HLukas1/CodeBlockSwitchT4/T4 Codeblock Switcher.stl

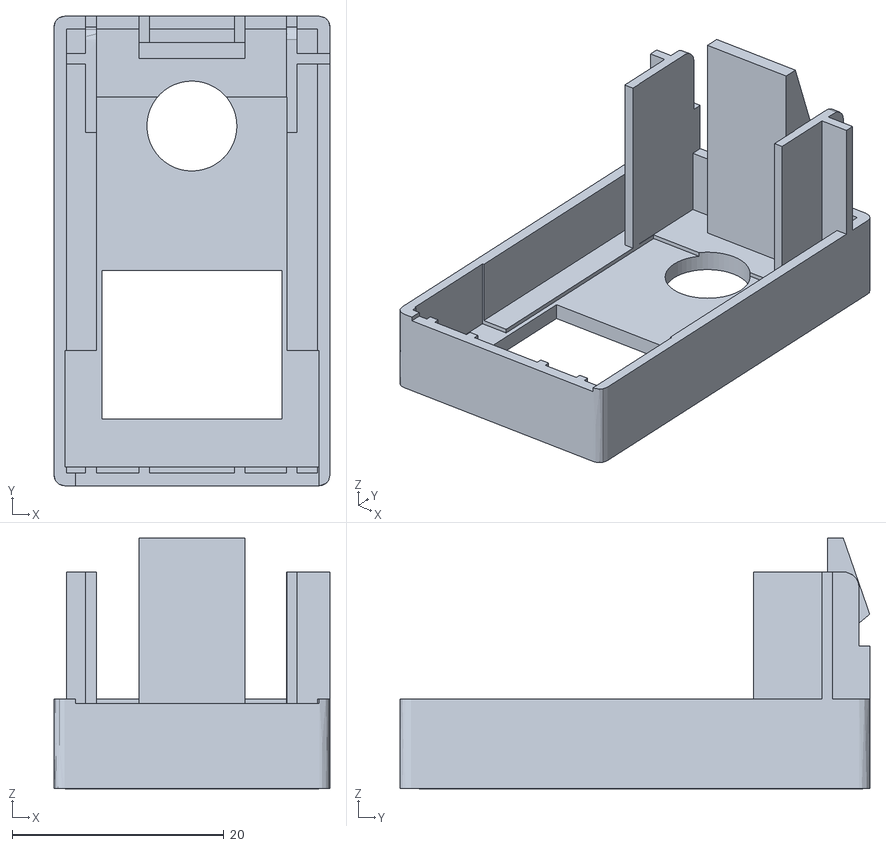
[picture p9: CAD file, 2026-11-06]
T4 Codeblock Switcher.stl
26.1 x 44.4 x 23.7
