HLukas1/CodeBlockSwitchT4/CodeBlockSwitchT4.ino

#include <Arduino.h>
#include <Wire.h>
#include <Adafruit_GFX.h>
#include <Adafruit_SSD1306.h>
#include <Fonts/FreeSans9pt7b.h>
#include <WiFi.h>
#include <WebServer.h>
#include <Preferences.h>
#include "WebPages.h"
#include "AppIcon.h"


// =====================================================
// ESP32-C3 / L9637D / KWP1281 /
//

#define KLINE_TX 10
#define KLINE_RX 1

#define MSG_ADDRESS 0x01

// =====================================================
// TESTBENCH-MODUS
// 0 = normaler Fahrzeugbetrieb
// 1 = Fahrzeugverbindung wird simuliert
// =====================================================
#define TESTBENCH_MODE 0

HardwareSerial obd(1);

//Displayeinstellungen
#define OLED_WIDTH 64
#define OLED_HEIGHT 48
#define OLED_RESET -1
#define OLED_ADDRESS 0x3C

#define OLED_SDA 6
#define OLED_SCL 7

Adafruit_SSD1306 display(
  OLED_WIDTH,
  OLED_HEIGHT,
  &Wire,
  OLED_RESET);

//Taster
#define BUTTON_INPUT 9
#define BUTTON_OUTPUT 5
// Eingebaute LED des ESP32-C3 SuperMini
#define LED_PIN 8

// Tastendauer - in der WebApp unter Einstellungen änderbar
// (Flash, Namespace "cfg"). Hier stehen die Standardwerte.
const uint32_t DEFAULT_LONG_PRESS_MS = 3000;

// Im Spannungsmodus -> Diagnose aus/an (K-Line frei für VCDS)
const uint32_t DEFAULT_DIAG_PRESS_MS = 5000;

volatile uint32_t buttonLongPressMs = DEFAULT_LONG_PRESS_MS;
volatile uint32_t buttonDiagPressMs = DEFAULT_DIAG_PRESS_MS;

// =====================================================
// EINSTELLUNGEN
// =====================================================

uint32_t KLINE_BAUD = 9600;

// 5 Baud = 200 ms pro Bit
const uint32_t FIVE_BAUD_BIT_US = 200000UL;

// Busruhe vor neuer Adressierung
const uint32_t BUS_IDLE_TIME_MS = 1200;

// Antwortabstand nach empfangenem Byte
const uint32_t TESTER_RESPONSE_DELAY_MS = 5;

// Abstand vor Komplement des zweiten Keybytes
const uint32_t KEYBYTE_COMPLEMENT_DELAY_MS = 30;

// Timeout innerhalb eines Blocks
const uint32_t INTERBYTE_TIMEOUT_MS = 55;

// Timeout zwischen zwei Blocks
const uint32_t INTERBLOCK_TIMEOUT_MS = 1100;

// Timeout waehrend Kommunikationsaufbau
const uint32_t INIT_TIMEOUT_MS = 250;

// Anzahl Verbindungsversuche
const uint8_t MAX_CONNECT_ATTEMPTS = 4;




// =====================================================
// GLOBALE VARIABLEN
// =====================================================

uint8_t blockCounter = 1;

uint16_t Coding = 0;
uint32_t WSC = 0;


uint16_t lastRpm = 0;
uint16_t lastBoostMbar = 0;
float injectionActual = 0.0;

float currentSpeed = 0.0;
float fuelConsumption = 0.0;

// =====================================================
// FAHRT-DURCHSCHNITT (nur RAM -> nach Neustart 0)
// =====================================================

float averageFuelConsumption = 0.0;

double tripFuelLiters = 0.0;
double tripDistanceKm = 0.0;

uint32_t lastAverageUpdateTime = 0;
uint32_t lastAverageMeasurementTime = 0;

// Durchschnitt alle 2 s aktualisieren
const uint32_t AVERAGE_MEASUREMENT_INTERVAL_MS = 2000;

// Unter dieser Geschwindigkeit nicht mitzählen (Standzeit)
const float FUEL_MIN_SPEED_KMH = 4.0f;

// Durchschnitt erst ab 100 m Fahrstrecke anzeigen
const double AVERAGE_MIN_DISTANCE_KM = 0.10;

// Glaettung Verbrauch (gleitender Mittelwert)
const uint8_t FUEL_AVG_SAMPLES = 35;

float fuelHourBuf[FUEL_AVG_SAMPLES] = {0};
float speedBuf[FUEL_AVG_SAMPLES] = {0};
uint8_t fuelBufIndex = 0;
uint8_t fuelBufCount = 0;

bool kwpConnected = false;

// Zeitpunkt des letzten vollständig empfangenen Blocks
uint32_t lastKwpRxTime = 0;

// Spätestens nach dieser Zeit ACK senden (SG-Timeout = 1100 ms)
const uint32_t KWP_KEEPALIVE_MS = 400;

// true = echter Leitungs-/Protokollfehler (Timeout, falsches Komplement)
// false = SG hat nur die Anfrage abgelehnt, Verbindung ist noch ok
bool kwpLinkError = false;

// Hilfsflag für kwpReceiveBlock-Wiederholung
bool kwpRxInterbyteTimeout = false;

// Aktuell im MSG vorhandene Codierung
uint16_t currentCodeblock = 0;

// =====================================================
// WLAN-HOTSPOT / WEBSERVER /SSID
// =====================================================

const char* AP_SSID = "CodeBlockSwitchT4";
const char* AP_PASS = "12345678";   // mind. 8 Zeichen

WebServer server(80);

// Zeitpunkt der letzten Webanfrage
uint32_t lastWebRequest = 0;

// So lange gilt die Webseite nach der letzten Anfrage als offen
const uint32_t WEB_ACTIVE_TIMEOUT_MS = 3000;

bool webClientActive() {
  return lastWebRequest != 0 &&
         (millis() - lastWebRequest) < WEB_ACTIVE_TIMEOUT_MS;
}


// =====================================================
// TASTER - EIGENER TASK + EREIGNIS-WARTESCHLANGE
// =====================================================

enum ButtonEvent : uint8_t {
  BTN_SHORT = 1,
  BTN_LONG  = 2,
  BTN_DIAG  = 3
};

QueueHandle_t buttonQueue = nullptr;

const uint32_t BUTTON_DEBOUNCE_MS = 30;
const uint32_t BUTTON_POLL_MS     = 5;
const uint8_t  BUTTON_QUEUE_LEN   = 10;

// Liegt ein noch nicht ausgeführter Tastendruck vor?
bool buttonPending() {
  return buttonQueue != nullptr &&
         uxQueueMessagesWaiting(buttonQueue) > 0;
}

// Messwertaktualisierung
uint32_t lastMeasurementTime = 0;
const uint32_t MEASUREMENT_INTERVAL_MS = 500;

uint32_t lastConnectAttempt = 0;
const uint32_t RECONNECT_PAUSE_MS = 15000;
// BETRIEBSMODI

enum DisplayMode {
  MODE_VOLTAGE,
  MODE_BOOST,
  MODE_CONSUMPTION,
  MODE_AVERAGE_CONSUMPTION,
  MODE_CUSTOM,
  MODE_CODEBLOCK
};

DisplayMode displayMode = MODE_VOLTAGE;

// =====================================================
// OLED-KONFIGURATION (wird im Flash gespeichert)
// =====================================================

Preferences prefs;

// Diagnose aus: keine K-Line-Kommunikation, Bildschirm fest auf
// Spannung. Bleibt nach Neustart erhalten (Namespace "diag").
bool diagDisabled = false;

const uint8_t SCR_VOLTAGE     = 0;
const uint8_t SCR_RPM         = 1;
const uint8_t SCR_BOOST       = 2;
const uint8_t SCR_CONSUMPTION = 3;
const uint8_t SCR_AVERAGE     = 4;
const uint8_t SCR_INJECTION   = 5;
const uint8_t SCR_CUSTOM1     = 10;   // 10..17 = eigene Messwerte

const uint8_t MAX_SCREENS = 12;
const uint8_t MAX_CUSTOM  = 8;

// Standard = bisherige Reihenfolge
uint8_t screenList[MAX_SCREENS] = {
  SCR_VOLTAGE, SCR_BOOST,
  SCR_CONSUMPTION, SCR_AVERAGE
};
uint8_t screenCount = 4;
uint8_t screenIndex = 0;
uint8_t currentScreenId = SCR_VOLTAGE;

// Eigene Messwerte (group = 0 -> Platz leer)
struct CustomScreen {
  uint8_t group;
  uint8_t field;

  // Automatisch aus der Messwerteblock-Tabelle übernommen
  char title[32];

  // Frei editierbare Einheit/Bezeichnung auf dem OLED
  char unit[10];
};

CustomScreen customScreens[MAX_CUSTOM];
uint8_t activeCustom = 0;

String customValueText = "-";
String customUnitText  = "";

// Letzte Livewerte aller eigenen Messwerte (für das Web-Dashboard)
String customLive[MAX_CUSTOM];
String customLiveUnit[MAX_CUSTOM];

// Einheiten der festen Bildschirme (Index = ID 0..5)
const char DEFAULT_UNITS[6][10] = {
  "V", "U/min", "mBar", "L/100km", "AVG L/100", "mg/Hub"
};

char baseUnits[6][10] = {
  "V", "U/min", "mBar", "L/100km", "AVG L/100", "mg/Hub"
};

// =====================================================
// VW STARTLOGO BITMAP 64x48
// =====================================================

const unsigned char vwLogo[] PROGMEM = {
  // 'Volkswagen-Logo-1967 (1)', 64x48px
  0x00, 0x00, 0x00, 0x00, 0x00, 0x00, 0x00, 0x00, 0x00, 0x00, 0x00, 0x00, 0x00, 0x00, 0x00, 0x00,
  0x00, 0x00, 0x00, 0x00, 0x00, 0x00, 0x00, 0x00, 0x00, 0x00, 0x00, 0x00, 0x00, 0x00, 0x00, 0x00,
  0x00, 0x00, 0x00, 0x0f, 0xf0, 0x00, 0x00, 0x00, 0x00, 0x00, 0x00, 0x7f, 0xfc, 0x00, 0x00, 0x00,
  0x00, 0x00, 0x00, 0xf0, 0x1e, 0x00, 0x00, 0x00, 0x00, 0x00, 0x01, 0xf0, 0x1f, 0x00, 0x00, 0x00,
  0x00, 0x00, 0x03, 0xb0, 0x19, 0x80, 0x00, 0x00, 0x00, 0x00, 0x03, 0x18, 0x19, 0xc0, 0x00, 0x00,
  0x00, 0x00, 0x06, 0x18, 0x30, 0xc0, 0x00, 0x00, 0x00, 0x00, 0x0c, 0x18, 0x30, 0x60, 0x00, 0x00,
  0x00, 0x00, 0x0c, 0x0c, 0x30, 0x60, 0x00, 0x00, 0x00, 0x00, 0x1c, 0x0c, 0x60, 0x70, 0x00, 0x00,
  0x00, 0x00, 0x1c, 0x06, 0x60, 0x70, 0x00, 0x00, 0x00, 0x00, 0x1e, 0x06, 0x40, 0xf0, 0x00, 0x00,
  0x00, 0x00, 0x12, 0x07, 0xc0, 0xd8, 0x00, 0x00, 0x00, 0x00, 0x13, 0x03, 0xc0, 0x98, 0x00, 0x00,
  0x00, 0x00, 0x33, 0x03, 0x81, 0x98, 0x00, 0x00, 0x00, 0x00, 0x31, 0x80, 0x01, 0x98, 0x00, 0x00,
  0x00, 0x00, 0x31, 0x80, 0x03, 0x08, 0x00, 0x00, 0x00, 0x00, 0x31, 0x83, 0x83, 0x18, 0x00, 0x00,
  0x00, 0x00, 0x10, 0xc3, 0x83, 0x18, 0x00, 0x00, 0x00, 0x00, 0x10, 0xc7, 0xc6, 0x18, 0x00, 0x00,
  0x00, 0x00, 0x18, 0xc6, 0xc6, 0x10, 0x00, 0x00, 0x00, 0x00, 0x18, 0x66, 0x64, 0x10, 0x00, 0x00,
  0x00, 0x00, 0x18, 0x6c, 0x6c, 0x30, 0x00, 0x00, 0x00, 0x00, 0x0c, 0x3c, 0x7c, 0x20, 0x00, 0x00,
  0x00, 0x00, 0x0c, 0x3c, 0x38, 0x60, 0x00, 0x00, 0x00, 0x00, 0x06, 0x38, 0x38, 0xc0, 0x00, 0x00,
  0x00, 0x00, 0x03, 0x18, 0x39, 0xc0, 0x00, 0x00, 0x00, 0x00, 0x03, 0x90, 0x13, 0x80, 0x00, 0x00,
  0x00, 0x00, 0x01, 0xf0, 0x1f, 0x00, 0x00, 0x00, 0x00, 0x00, 0x00, 0x78, 0x1e, 0x00, 0x00, 0x00,
  0x00, 0x00, 0x00, 0x3f, 0xf8, 0x00, 0x00, 0x00, 0x00, 0x00, 0x00, 0x0f, 0xe0, 0x00, 0x00, 0x00,
  0x00, 0x00, 0x00, 0x00, 0x00, 0x00, 0x00, 0x00, 0x00, 0x00, 0x00, 0x00, 0x00, 0x00, 0x00, 0x00,
  0x00, 0x00, 0x00, 0x00, 0x00, 0x00, 0x00, 0x00, 0x00, 0x00, 0x00, 0x00, 0x00, 0x00, 0x00, 0x00
};



// =====================================================
// KWP1281 MESSWERT
// =====================================================

struct KwpValue {
  bool    valid;    // Feld vorhanden und gelesen
  bool    isText;   // true = Ergebnis ist Text (z.B. COLD/WARM)
  uint8_t formula;  // Kennzahl (Byte 1)
  uint8_t a;        // Byte 2
  uint8_t b;        // Byte 3
  double  value;    // umgerechneter Messwert
  String  unit;     // Einheit
  String  text;     // Textergebnis
};

const uint8_t KWP_MAX_FIELDS = 4;

// =====================================================
// WEB: FREIE MESSWERTBLOCK-ANZEIGE
// =====================================================

uint8_t  webMwbGroup   = 0;      // gewünschter Block (0 = keiner)
uint32_t lastMwbRequest = 0;

KwpValue mwbData[KWP_MAX_FIELDS];
uint8_t  mwbCount     = 0;       // Anzahl gelesener Felder
uint8_t  mwbDataGroup = 0;       // Block, zu dem mwbData gehört
bool     mwbError     = false;

// =====================================================
// WEB: FEHLERSPEICHER
// =====================================================

struct KwpFault {
  uint16_t code;
  uint8_t type;
  bool sporadic;
};

const uint8_t KWP_MAX_FAULTS = 32;

KwpFault faultData[KWP_MAX_FAULTS];
uint8_t faultCount = 0;

bool faultMemoryValid = false;
bool faultMemoryError = false;
bool faultMemoryEmpty = false;
bool faultRequestRunning = false;

String faultStatusText = "Noch nicht gelesen";
// true = Fehlerspeicher wird gerade beim Start gelesen
bool startupFaultCheck = false;

// FSP-Hinweis nach dem Startcheck (10 s statt Spannung)
bool fspNoticeActive = false;
uint32_t fspNoticeStart = 0;
const uint32_t FSP_NOTICE_MS = 10000;

enum FaultRequestType {
  FAULT_REQUEST_NONE,
  FAULT_REQUEST_READ,
  FAULT_REQUEST_CLEAR
};

volatile FaultRequestType pendingFaultRequest =
  FAULT_REQUEST_NONE;
  
#include "FaultTable.h"

// Wird die MWB-Seite gerade abgefragt?
bool mwbActive() {
  return webMwbGroup > 0 &&
         lastMwbRequest != 0 &&
         (millis() - lastMwbRequest) < 3000;
}

String jsonEscape(const String &s) {
  String o;
  for (size_t i = 0; i < s.length(); i++) {
    char c = s[i];
    if (c == '"' || c == '\\') { o += '\\'; o += c; }
    else if ((uint8_t)c < 0x20) { o += '?'; }
    else o += c;   // UTF-8 (Umlaute, °) bleibt erhalten
  }
  return o;
}

#include "MwbTable.h"

// =====================================================
// FUNKTIONSPROTOTYPEN
// =====================================================

void printHex(uint8_t value);
void waitUntilMicros(uint32_t targetTime);

void stopKLine(bool waitForBusIdle);
void startKLine();
void clearKLineInput();

bool obdReadByte(uint8_t &value, uint32_t timeoutMs);
void obdWriteByte(uint8_t value);

void send5BaudAddress(uint8_t address);
bool readInitialResponse();

bool kwpReceiveBlock(
  uint8_t *buffer,
  uint16_t maxSize,
  uint16_t &size);

bool kwpSendBlockOnce(
  const uint8_t *buffer,
  uint16_t size);

bool kwpSendBlock(
  const uint8_t *buffer,
  uint16_t size);

bool kwpSendAck();
bool kwpSendEnd();

bool parseCodingBlock(
  const uint8_t *buffer,
  uint16_t size);

bool readIdentificationBlocks();

bool connectMSGOnce();
bool connectMSG(uint8_t maxAttempts = MAX_CONNECT_ATTEMPTS);
void disconnectMSG();

bool sendCoding(
  uint16_t requestedCoding,
  uint32_t requestedWSC);


void decodeKwpValue(KwpValue &v);

bool readMeasurementGroup(
  uint8_t group,
  KwpValue values[],
  uint8_t &fieldCount,
  bool printAllFields);

bool readMeasurement(
  uint8_t group,
  uint8_t field,
  KwpValue &out,
  bool printAllFields);

bool faultPageActive();

void calculateFuelConsumption();
float calculateLitersPerHour(uint16_t rpm, float injection);
void updateAverageFuelConsumption(float litersPerHour, float speedKmh);
bool readTripAverageValues();

void oledShowCustom();
void updateVoltageDisplay();
void applyScreen(uint8_t id);
void setCustomValue(bool isText, const String &text, double value, const String &unit);

bool readFaultMemory();
bool clearFaultMemory();
bool receiveFaultMemoryResponse();
bool parseFaultBlock(const uint8_t *buffer, uint16_t size);
void processFaultRequest();
String faultTypeText(uint8_t type);
String faultCodeText(uint16_t code);

int16_t getCenteredX(String text) {
  int16_t x1, y1;
  uint16_t w, h;

  display.getTextBounds(
    text,
    0,
    0,
    &x1,
    &y1,
    &w,
    &h);

  return (OLED_WIDTH - w) / 2;
}
// =====================================================
// HEX-AUSGABE
// =====================================================

void printHex(uint8_t value) {
  if (value < 0x10) {
    Serial.print("0");
  }

  Serial.print(value, HEX);
}


// =====================================================
// ZEITGENAUES WARTEN
// =====================================================

void waitUntilMicros(uint32_t targetTime) {
  while ((int32_t)(targetTime - micros()) > 0) {
    delayMicroseconds(50);
  }
}


// =====================================================
// K-LINE STOPPEN
// =====================================================

void stopKLine(bool waitForBusIdle) {
  obd.end();

  pinMode(KLINE_TX, OUTPUT);
  digitalWrite(KLINE_TX, HIGH);

  pinMode(KLINE_RX, INPUT);

  if (waitForBusIdle) {
    delay(BUS_IDLE_TIME_MS);
  }
}


// =====================================================
// K-LINE UART STARTEN
// =====================================================

void startKLine() {
  obd.end();

  obd.begin(
    KLINE_BAUD,
    SERIAL_8N1,
    KLINE_RX,
    KLINE_TX);
}


// =====================================================
// K-LINE-EINGANGSPUFFER LEEREN
// =====================================================

void clearKLineInput() {
  while (obd.available()) {
    obd.read();
  }
}




// =====================================================
// BYTE VON K-LINE LESEN
// =====================================================

bool obdReadByte(
  uint8_t &value,
  uint32_t timeoutMs) {
  uint32_t startTime = millis();

  while (!obd.available()) {
    if ((uint32_t)(millis() - startTime) >= timeoutMs) {
      return false;
    }

    delay(1);
  }

  value = (uint8_t)obd.read();

  return true;
}


// =====================================================
// BYTE AUF K-LINE SENDEN
// =====================================================

void obdWriteByte(uint8_t value) {
  obd.write(value);
  obd.flush();

  // Laut KW1281-Protokoll wird jedes vom µC gesendete
  // Byte vom Bus als Echo zurückgespiegelt, noch bevor
  // die eigentliche Antwort des Steuergeraets kommt.
  // Dieses Echo muss verworfen werden.
  uint8_t echo = 0;

  if (!obdReadByte(echo, INTERBYTE_TIMEOUT_MS)) {
    Serial.println("WARNUNG: Kein Echo auf gesendetes Byte.");
  } else if (echo != value) {
    Serial.print("WARNUNG: Echo 0x");
    printHex(echo);
    Serial.print(" weicht von gesendetem Byte 0x");
    printHex(value);
    Serial.println(" ab.");
  }
}


// =====================================================
// 5-BAUD-ADRESSE SENDEN
//
// 1 Startbit Low
// 7 Datenbits LSB zuerst
// 1 Bit ungerade Paritaet
// 1 Stopbit High
// =====================================================

void send5BaudAddress(uint8_t address) {
  Serial.println();
  Serial.println("========================================");
  Serial.println("       5-BAUD INITIALISIERUNG");
  Serial.println("========================================");

  stopKLine(true);

  uint8_t bits[10];

  // Startbit
  bits[0] = 0;

  uint8_t parity = 0;

  // Sieben Datenbits, LSB zuerst
  for (uint8_t i = 0; i < 7; i++) {
    uint8_t currentBit =
      (address >> i) & 0x01;

    bits[i + 1] = currentBit;

    parity ^= currentBit;
  }

  // Ungerade Paritaet
  bits[8] = parity ? 0 : 1;

  // Stopbit
  bits[9] = 1;

  Serial.print("Adresse: 0x");
  printHex(address);
  Serial.println();

  Serial.print("Bitfolge: ");

  for (uint8_t i = 0; i < 10; i++) {
    Serial.print(bits[i]);
  }

  Serial.println();

  uint32_t nextBitTime = micros();

  for (uint8_t i = 0; i < 10; i++) {
    digitalWrite(
      KLINE_TX,
      bits[i] ? HIGH : LOW);

    nextBitTime += FIVE_BAUD_BIT_US;

    waitUntilMicros(nextBitTime);
  }

  digitalWrite(KLINE_TX, HIGH);

  Serial.println("5-Baud-Adresse gesendet.");
}


// =====================================================
// INITIALANTWORT LESEN
//
// Erwartet:
//   55 01 8A
//
// Danach sendet der Tester:
//   75 = 8A XOR FF
// =====================================================

bool readInitialResponse() {
  Serial.println();
  Serial.println("----------------------------------------");
  Serial.println("        WARTE AUF 55 01 8A");
  Serial.println("----------------------------------------");

  uint8_t syncByte = 0;
  uint8_t keyByte1 = 0;
  uint8_t keyByte2 = 0;

  if (!obdReadByte(syncByte, INIT_TIMEOUT_MS)) {
    Serial.println(
      "FEHLER: Kein Synchronisationsbyte.");

    return false;
  }

  Serial.print("SYNC: 0x");
  printHex(syncByte);
  Serial.println();

  if (syncByte != 0x55) {
    Serial.println(
      "FEHLER: Synchronisationsbyte ist nicht 0x55.");

    return false;
  }

  if (!obdReadByte(keyByte1, INIT_TIMEOUT_MS)) {
    Serial.println("FEHLER: Keybyte 1 fehlt.");

    return false;
  }

  Serial.print("KB1: 0x");
  printHex(keyByte1);
  Serial.println();

  if (!obdReadByte(keyByte2, INIT_TIMEOUT_MS)) {
    Serial.println("FEHLER: Keybyte 2 fehlt.");

    return false;
  }

  Serial.print("KB2: 0x");
  printHex(keyByte2);
  Serial.println();

  if (
    keyByte1 != 0x01 || keyByte2 != 0x8A) {
    Serial.println(
      "FEHLER: Erwartetes Keyword 01 8A fehlt.");

    return false;
  }

  delay(KEYBYTE_COMPLEMENT_DELAY_MS);

  uint8_t complement =
    keyByte2 ^ 0xFF;

  Serial.print("TX KB2-Komplement: 0x");
  printHex(complement);
  Serial.println();

  obdWriteByte(complement);

  // Der erste Datenblock hat Blockzaehler 1.
  blockCounter = 1;

  return true;
}

// =====================================================
// KWP1281-BLOCK EINMAL EMPFANGEN
// =====================================================

bool kwpReceiveBlockOnce(
  uint8_t *buffer,
  uint16_t maxSize,
  uint16_t &size) {
  size = 0;

  uint8_t value = 0;

  // Merker: Abbruch mitten im Block?
  kwpRxInterbyteTimeout = false;

  Serial.println();
  Serial.print("Warte auf Block ");
  Serial.println(blockCounter);

  // Erstes Byte mit Interblock-Timeout
  if (!obdReadByte(
        value,
        INTERBLOCK_TIMEOUT_MS)) {
    Serial.println("FEHLER: Interblock-Timeout.");

    return false;
  }

  size = (uint16_t)value + 1U;

  if (size < 4) {
    Serial.println("FEHLER: Block zu klein.");

    return false;
  }

  if (size > maxSize) {
    Serial.println("FEHLER: Block zu gross.");

    return false;
  }

  buffer[0] = value;

  // Blocklaenge komplementieren
  delay(TESTER_RESPONSE_DELAY_MS);
  obdWriteByte(value ^ 0xFF);

  for (uint16_t index = 1; index < size; index++) {
    if (!obdReadByte(
          value,
          INTERBYTE_TIMEOUT_MS)) {
      Serial.print(
        "FEHLER: Interbyte-Timeout bei Index ");

      Serial.println(index);

      // SG wiederholt diesen Block laut KWP1281
      kwpRxInterbyteTimeout = true;

      return false;
    }

    buffer[index] = value;

    // Das letzte Byte ETX wird nicht komplementiert.
    if (index < size - 1) {
      delay(TESTER_RESPONSE_DELAY_MS);
      obdWriteByte(value ^ 0xFF);
    }
  }

  if (buffer[size - 1] != 0x03) {
    Serial.print("FEHLER: Ungueltiges ETX 0x");
    printHex(buffer[size - 1]);
    Serial.println();

    return false;
  }

  if (buffer[1] != blockCounter) {
    Serial.print(
      "FEHLER: Blockzaehler empfangen 0x");

    printHex(buffer[1]);

    Serial.print(", erwartet 0x");
    printHex(blockCounter);

    Serial.println();

    return false;
  }

  Serial.print("RX BLOCK: ");

  for (uint16_t i = 0; i < size; i++) {
    printHex(buffer[i]);
    Serial.print(" ");
  }

  Serial.println();

  blockCounter++;

  return true;
}


// =====================================================
// KWP1281-BLOCK EMPFANGEN MIT WIEDERHOLUNG
//
// Bricht der Empfang mitten im Block ab, sendet das SG
// den Block nach seinem Timeout erneut. Darauf wird
// einmal gewartet.
// =====================================================

bool kwpReceiveBlock(
  uint8_t *buffer,
  uint16_t maxSize,
  uint16_t &size) {

  for (uint8_t attempt = 0; attempt < 2; attempt++) {

    if (kwpReceiveBlockOnce(buffer, maxSize, size)) {
      // Erfolgreich -> Zeitstempel für Keep-Alive
      lastKwpRxTime = millis();
      return true;
    }

    // Nur bei Abbruch mitten im Block wiederholt das SG
    if (!kwpRxInterbyteTimeout) {
      break;
    }

    Serial.println("Warte auf Blockwiederholung durch SG...");

    // Reste des abgebrochenen Blocks verwerfen
    clearKLineInput();
  }

  // Endgültig fehlgeschlagen -> echter Leitungsfehler
  kwpLinkError = true;
  return false;
}


// =====================================================
// KWP1281-BLOCK EINMAL SENDEN
// =====================================================

bool kwpSendBlockOnce(
  const uint8_t *buffer,
  uint16_t size) {
  if (size < 4) {
    Serial.println("FEHLER: TX-Block zu klein.");

    return false;
  }

  if (buffer[1] != blockCounter) {
    Serial.print(
      "FEHLER: TX-Blockzaehler 0x");

    printHex(buffer[1]);

    Serial.print(", erwartet 0x");
    printHex(blockCounter);

    Serial.println();

    return false;
  }

  if (buffer[size - 1] != 0x03) {
    Serial.println("FEHLER: TX-Block ohne ETX.");

    return false;
  }

  Serial.print("TX BLOCK: ");

  for (uint16_t i = 0; i < size; i++) {
    printHex(buffer[i]);
    Serial.print(" ");
  }

  Serial.println();

  for (uint16_t index = 0; index < size; index++) {
    delay(TESTER_RESPONSE_DELAY_MS);

    uint8_t sentByte = buffer[index];

    obdWriteByte(sentByte);

    // Kein Komplement fuer ETX
    if (index == size - 1) {
      continue;
    }

    uint8_t receivedComplement = 0;

    if (!obdReadByte(
          receivedComplement,
          INTERBYTE_TIMEOUT_MS)) {
      Serial.print(
        "FEHLER: Kein Komplement fuer 0x");

      printHex(sentByte);
      Serial.println();

      return false;
    }

    uint8_t expectedComplement =
      sentByte ^ 0xFF;

    if (receivedComplement != expectedComplement) {
      Serial.print(
        "FEHLER: Komplement empfangen 0x");

      printHex(receivedComplement);

      Serial.print(", erwartet 0x");
      printHex(expectedComplement);

      Serial.println();

      return false;
    }
  }

  return true;
}


// =====================================================
// KWP1281-BLOCK MIT WIEDERHOLUNG SENDEN
// =====================================================

bool kwpSendBlock(
  const uint8_t *buffer,
  uint16_t size) {
  const uint8_t maxAttempts = 3;

  for (
    uint8_t attempt = 1;
    attempt <= maxAttempts;
    attempt++) {
    if (kwpSendBlockOnce(buffer, size)) {
      blockCounter++;

      return true;
    }

    if (attempt < maxAttempts) {
      Serial.print("Blockwiederholung ");
      Serial.print(attempt + 1);
      Serial.print(" von ");
      Serial.println(maxAttempts);

      delay(INTERBYTE_TIMEOUT_MS * 2UL);

      clearKLineInput();
    }
  }
  kwpLinkError = true;
  return false;
}


// =====================================================
// B01 ACKNOWLEDGE
//
// 03 ZZ 09 03
// =====================================================

bool kwpSendAck() {
  uint8_t block[4];

  block[0] = 0x03;
  block[1] = blockCounter;
  block[2] = 0x09;
  block[3] = 0x03;

  return kwpSendBlock(
    block,
    sizeof(block));
}


// =====================================================
// B03 AUSGABE-ENDE
//
// 03 ZZ 06 03
// =====================================================

bool kwpSendEnd() {
  uint8_t block[4];

  block[0] = 0x03;
  block[1] = blockCounter;
  block[2] = 0x06;
  block[3] = 0x03;

  Serial.println();
  Serial.println("Sende B03 Ausgabe-Ende.");

  bool result =
    kwpSendBlock(
      block,
      sizeof(block));

  kwpConnected = false;

  return result;
}

// =====================================================
// KEEP-ALIVE: B01 senden, B01 vom SG empfangen
// Hält die Verbindung ohne Neuadressierung offen
// =====================================================

void kwpKeepAlive() {
#if TESTBENCH_MODE
  return;
#endif

  if (!kwpConnected || faultRequestRunning) return;
  if (millis() - lastKwpRxTime < KWP_KEEPALIVE_MS) return;

  uint8_t buf[64];
  uint16_t size = 0;

  if (kwpSendAck() && kwpReceiveBlock(buf, sizeof(buf), size)) {
    return;   // normalerweise kommt 0x09 zurück
  }

  Serial.println("Keep-Alive fehlgeschlagen, Verbindung verloren.");
  stopKLine(false);
  kwpConnected = false;
  lastConnectAttempt = millis();
}

// =====================================================
// CODIERUNGSBLOCK AUSWERTEN
//
// Empfang:
//   08 ZZ F6 00 PP0 PP1 PP2 PP3 03
//
// Coding:
//   Coding = (PP0 PP1) / 2
//
// WSC:
//   PP1 Bit 0 = WSC16
//   PP2       = WSC15 bis WSC08
//   PP3       = WSC07 bis WSC00
// =====================================================

bool parseCodingBlock(
  const uint8_t *buffer,
  uint16_t size) {
  if (size != 9) {
    return false;
  }

  if (
    buffer[2] != 0xF6 || buffer[3] != 0x00 || buffer[8] != 0x03) {
    return false;
  }

  uint8_t pp0 = buffer[4];
  uint8_t pp1 = buffer[5];
  uint8_t pp2 = buffer[6];
  uint8_t pp3 = buffer[7];

  uint16_t codingRaw =
    ((uint16_t)pp0 << 8) | (uint16_t)pp1;

  Coding = codingRaw >> 1;

  WSC =
    ((uint32_t)(pp1 & 0x01) << 16) | ((uint32_t)pp2 << 8) | (uint32_t)pp3;

  Serial.println();
  Serial.println("************************************");
  Serial.println("        CODIERUNG EMPFANGEN");
  Serial.println("************************************");

  Serial.print("PP0 = 0x");
  printHex(pp0);

  Serial.print("  PP1 = 0x");
  printHex(pp1);

  Serial.print("  PP2 = 0x");
  printHex(pp2);

  Serial.print("  PP3 = 0x");
  printHex(pp3);

  Serial.println();

  Serial.print("Codierung = ");
  Serial.println(Coding);

  Serial.print("WSC       = ");
  Serial.println(WSC);

  Serial.println("************************************");

  return true;
}


// =====================================================
// IDENTIFIKATIONSBLOECKE LESEN
//
// Nach abschliessendem B01 bleibt die Verbindung offen.
// Der Tester besitzt dann die Master-Funktion.
// =====================================================

bool readIdentificationBlocks() {
  String identificationText = "";

  uint8_t buffer[256];
  uint16_t size = 0;

  uint8_t safetyCounter = 0;

  while (safetyCounter < 40) {
    safetyCounter++;

    if (!kwpReceiveBlock(
          buffer,
          sizeof(buffer),
          size)) {
      return false;
    }

    uint8_t blockTitle = buffer[2];

    if (blockTitle == 0xF6) {
      if (!parseCodingBlock(buffer, size)) {
        for (
          uint16_t i = 3;
          i < size - 1;
          i++) {
          uint8_t data = buffer[i];

          if (
            data >= 0x20 && data <= 0x7E) {
            identificationText +=
              (char)data;
          }
        }
      }

      if (!kwpSendAck()) {
        Serial.println(
          "FEHLER: B01 konnte nicht gesendet werden.");

        return false;
      }

      continue;
    }

    if (blockTitle == 0x09) {
      Serial.println();
      Serial.println(
        "B01 vom Steuergeraet empfangen.");

      Serial.println(
        "Tester besitzt jetzt die Master-Funktion.");

      if (identificationText.length() > 0) {
        Serial.print("MSG-Identifikation: ");
        Serial.println(identificationText);
      }

      return true;
    }

    if (blockTitle == 0x06) {
      Serial.println(
        "B03 vom Steuergeraet empfangen.");

      kwpConnected = false;

      return false;
    }

    if (blockTitle == 0x0A) {
      Serial.println(
        "FEHLER: No-Acknowledge empfangen.");

      return false;
    }

    Serial.print(
      "FEHLER: Unerwarteter Blocktitel 0x");

    printHex(blockTitle);
    Serial.println();

    return false;
  }

  Serial.println(
    "FEHLER: Zu viele Identifikationsbloecke.");

  return false;
}


// =====================================================
// EIN VERBINDUNGSVERSUCH
// =====================================================

bool connectMSGOnce() {
  kwpConnected = false;

  blockCounter = 1;
  Coding = 0;
  WSC = 0;

  send5BaudAddress(MSG_ADDRESS);

  // UART unmittelbar nach 5-Baud-Adresswort starten.
  startKLine();

  // Eingangspuffer hier nicht leeren.
  // Sonst kann 0x55 verloren gehen.

  if (!readInitialResponse()) {
    stopKLine(false);

    return false;
  }

  kwpConnected = true;

  if (!readIdentificationBlocks()) {
    kwpConnected = false;

    stopKLine(false);

    return false;
  }

  return true;
}


// =====================================================
// VERBINDEN MIT WIEDERHOLUNG
// =====================================================

bool connectMSG(uint8_t maxAttempts) { 

#if TESTBENCH_MODE
  kwpConnected = true;
  Coding = 2;
  WSC = 0;
 
  Serial.println("TESTBENCH: Fahrzeugverbindung simuliert.");
  return true;
#endif

  // Ab hier bleibt der bisherige Code von connectMSG()

  if (kwpConnected) {
    return true;
  }
  for (
    uint8_t attempt = 1;
    attempt <= maxAttempts;
    attempt++) {
    Serial.println();
    Serial.print("Verbindungsversuch ");
    Serial.print(attempt);
    Serial.print(" von ");
    Serial.println(maxAttempts);   

    if (connectMSGOnce()) {
      Serial.println();
      Serial.println("MSG verbunden.");

      Serial.print("Aktuelle Codierung: ");
      Serial.println(Coding);

      Serial.print("Aktueller WSC: ");
      Serial.println(WSC);

      return true;
    }

    Serial.println(
      "Verbindungsversuch fehlgeschlagen.");

    stopKLine(true);
  }

  Serial.println();
  Serial.println(
    "FEHLER: Keine Verbindung zum MSG.");

  return false;
}


// =====================================================
// VERBINDUNG BEENDEN
// =====================================================

void disconnectMSG() {

  if (kwpConnected) {

    if (!kwpSendEnd()) {

      Serial.println(
        "WARNUNG: B03 konnte nicht gesendet werden.");

      // Verbindung trotzdem hart beenden
      stopKLine(false);
      kwpConnected = false;

      return;
    }
  }

  stopKLine(false);

  kwpConnected = false;
}


// =====================================================
// B13 CODIERUNG SENDEN
//
// 07 ZZ 10 PP0 PP1 PP2 PP3 03
// =====================================================

bool sendCoding(
  uint16_t requestedCoding,
  uint32_t requestedWSC) {

#if TESTBENCH_MODE

  Serial.println("TESTBENCH: Codeblock-Schreiben simuliert.");

  Coding = requestedCoding;
  WSC = requestedWSC;

  return true;

#endif

  if (!kwpConnected) {
    Serial.println(
      "FEHLER: Keine aktive Verbindung.");

    return false;
  }

  if (requestedCoding > 32767) {
    Serial.println(
      "FEHLER: Codierung muss 0 bis 32767 sein.");

    return false;
  }

  if (requestedWSC > 131071UL) {
    Serial.println(
      "FEHLER: WSC muss 0 bis 131071 sein.");

    return false;
  }

  uint16_t codingRaw =
    (uint16_t)(requestedCoding << 1);

  uint8_t pp0 =
    (uint8_t)((codingRaw >> 8) & 0xFF);

  uint8_t pp1 =
    (uint8_t)(codingRaw & 0xFE);

  if (requestedWSC & 0x10000UL) {
    pp1 |= 0x01;
  }

  uint8_t pp2 =
    (uint8_t)((requestedWSC >> 8) & 0xFF);

  uint8_t pp3 =
    (uint8_t)(requestedWSC & 0xFF);

  uint8_t block[8];

  block[0] = 0x07;
  block[1] = blockCounter;
  block[2] = 0x10;
  block[3] = pp0;
  block[4] = pp1;
  block[5] = pp2;
  block[6] = pp3;
  block[7] = 0x03;

  Serial.println();
  Serial.println("========================================");
  Serial.println("       SENDE NEUE CODIERUNG");
  Serial.println("========================================");

  Serial.print("Neue Codierung: ");
  Serial.println(requestedCoding);

  Serial.print("Neuer WSC: ");
  Serial.println(requestedWSC);

  if (!kwpSendBlock(
        block,
        sizeof(block))) {
    Serial.println(
      "FEHLER: B13 konnte nicht gesendet werden.");

    return false;
  }

  // Nach B13 sendet das MSG erneut
  // die Identifikationsbloecke.
  if (!readIdentificationBlocks()) {
    Serial.println(
      "FEHLER: Keine Identifikation nach B13.");

    return false;
  }

  if (Coding != requestedCoding) {
    Serial.println();
    Serial.println(
      "FEHLER: Codierung wurde nicht uebernommen.");

    Serial.print("Angefordert: ");
    Serial.println(requestedCoding);

    Serial.print("Zurueckgelesen: ");
    Serial.println(Coding);

    return false;
  }

  Serial.println();
  Serial.println(
    "Codierung erfolgreich uebernommen.");

  Serial.print("Zurueckgelesene Codierung: ");
  Serial.println(Coding);

  Serial.print("Zurueckgelesener WSC: ");
  Serial.println(WSC);

  return true;
}

// =====================================================
// FEHLERSPEICHER: HILFSFUNKTIONEN
// =====================================================

String faultCodeText(uint16_t code) {
  String text = String(code);
  while (text.length() < 5) text = "0" + text;
  return text;
}

// Bit 7 = sporadisch, Bit 0..6 = Fehlerart
String faultTypeText(uint8_t type) {
  switch (type & 0x7F) {
    case 0x00: return "keine Angabe";
    case 0x01: return "Kurzschluss nach Plus";
    case 0x02: return "Kurzschluss nach Masse";
    case 0x03: return "kein Signal";
    case 0x04: return "mechanischer Fehler";
    case 0x05: return "Eingang offen";
    case 0x06: return "Signal zu groß";
    case 0x07: return "Signal zu klein";
    case 0x08: return "unplausibles Signal";
    case 0x09: return "Unterbrechung / Kurzschluss nach Masse";
    case 0x0A: return "Unterbrechung / Kurzschluss nach Plus";
    case 0x0B: return "Kurzschluss";
    case 0x0C: return "elektrischer Fehler";
    case 0x0D: return "bitte Fehlerspeicher auslesen";
    case 0x0E: return "defekt";
	case 0x23: return "";   // SAE/P-Code-Kennung, keine eigene Fehlerart
    default:   return "Fehlerart " + String(type & 0x7F);
  }
}

// =====================================================
// 0xFC-BLOCK AUSWERTEN
// LL ZZ FC [HH LL ART] x n 03
// =====================================================

bool parseFaultBlock(const uint8_t *buffer, uint16_t size) {
  if (size < 7 || buffer[2] != 0xFC) {
    Serial.println("FEHLER: Ungueltiger Fehlerspeicherblock.");
    return false;
  }

  if (((size - 4) % 3) != 0) {
    Serial.println("FEHLER: Ungueltige Anzahl Fehlerbytes.");
    return false;
  }

  for (uint16_t pos = 3; pos + 2 < size - 1; pos += 3) {
    uint16_t code = ((uint16_t)buffer[pos] << 8) | buffer[pos + 1];
    uint8_t type = buffer[pos + 2];

    // FFFF 88 = kein Fehler erkannt
    if (code == 0xFFFF && type == 0x88) {
      faultMemoryEmpty = true;
      continue;
    }

    if (faultCount >= KWP_MAX_FAULTS) continue;

    faultData[faultCount].code = code;
    faultData[faultCount].type = type;
    faultData[faultCount].sporadic = (type & 0x80) != 0;

    Serial.print("Fehler ");
    Serial.print(faultCodeText(code));
    Serial.print("  Art 0x");
    printHex(type);
    Serial.println(faultData[faultCount].sporadic ? "  sporadisch" : "  statisch");

    faultCount++;
  }

  return true;
}

// =====================================================
// ANTWORT EMPFANGEN (mehrere 0xFC-Bloecke moeglich)
// Jeder 0xFC wird mit B01 bestaetigt, Ende = B01 vom SG
// =====================================================

bool receiveFaultMemoryResponse() {
  uint8_t response[256];
  uint16_t responseSize = 0;

  for (uint8_t i = 0; i < 40; i++) {
    if (!kwpReceiveBlock(response, sizeof(response), responseSize)) {
      return false;
    }

    uint8_t title = response[2];

    if (title == 0xFC) {
      if (!parseFaultBlock(response, responseSize)) return false;
      if (!kwpSendAck()) return false;
      continue;
    }

    if (title == 0x09) return true;          // fertig

    if (title == 0x0A) {
      Serial.println("FEHLER: No-Acknowledge.");
      return false;
    }

    if (title == 0x06) {
      kwpConnected = false;
      return false;
    }

    Serial.print("FEHLER: Unerwarteter Blocktitel 0x");
    printHex(title);
    Serial.println();
    return false;
  }

  return false;
}

// =====================================================
// B06 LESEN: 03 ZZ 07 03
// =====================================================

bool readFaultMemory() {
  faultCount = 0;
  faultMemoryEmpty = false;

#if TESTBENCH_MODE
  faultData[0] = {257, 0x05, false};
  faultData[1] = {515, 0x88, true};
  faultCount = 2;
  return true;
#endif

  if (!kwpConnected) return false;

  uint8_t request[4] = {0x03, blockCounter, 0x07, 0x03};

  Serial.println("\n===== FEHLERSPEICHER LESEN =====");

  if (!kwpSendBlock(request, sizeof(request))) return false;

  return receiveFaultMemoryResponse();
}

// =====================================================
// B07 LOESCHEN: 03 ZZ 05 03
// SG gibt danach den Fehlerspeicher erneut aus
// =====================================================

bool clearFaultMemory() {
  faultCount = 0;
  faultMemoryEmpty = false;

#if TESTBENCH_MODE
  faultMemoryEmpty = true;
  return true;
#endif

  if (!kwpConnected) return false;

  uint8_t request[4] = {0x03, blockCounter, 0x05, 0x03};

  Serial.println("\n===== FEHLERSPEICHER LOESCHEN =====");

  if (!kwpSendBlock(request, sizeof(request))) return false;

  return receiveFaultMemoryResponse();
}

// =====================================================
// KWP1281 MESSWERT UMRECHNUNG ANHAND KENNZAHL
// Quelle: Klien Kennzahlen.xlsx
// =====================================================

void decodeKwpValue(KwpValue &v) {
  double a = v.a;
  double b = v.b;

  v.value  = 0.0;
  v.unit   = "";
  v.text   = "";
  v.isText = false;

  switch (v.formula) {
    case 1:  v.value = 0.2 * a * b;               v.unit = "U/min";   break;
    case 2:  v.value = a * 0.002 * b;             v.unit = "%";       break;
    case 3:  v.value = 0.002 * a * b;             v.unit = "Deg";     break;
    case 4:  v.value = fabs(b - 127) * 0.01 * a;
             v.unit  = (v.b > 127) ? "ATDC" : "BTDC";                break;
    case 5:  v.value = a * (b - 100) * 0.1;       v.unit = "C";       break;
    case 6:  v.value = 0.001 * a * b;             v.unit = "V";       break;
    case 7:  v.value = 0.01 * a * b;              v.unit = "km/h";    break;
    case 8:  v.value = 0.1 * a * b;               v.unit = "";        break;
    case 9:  v.value = (b - 127) * 0.02 * a;      v.unit = "Deg";     break;
    case 10: v.isText = true; v.text = (v.b == 0) ? "COLD" : "WARM";  break;
    case 11: v.value = 0.0001 * a * (b - 128) + 1; v.unit = "";       break;
    case 12: v.value = 0.001 * a * b;             v.unit = "Ohm";     break;
    case 13: v.value = (b - 127) * 0.001 * a;     v.unit = "mm";      break;
    case 14: v.value = 0.005 * a * b;             v.unit = "bar";     break;
    case 15: v.value = 0.01 * a * b;              v.unit = "ms";      break;
    case 16: v.isText = true; v.value = v.b;
             v.text = String(v.b, BIN);           v.unit = "bit";     break;
    case 17: v.isText = true;
             v.text = String((char)v.a) + String((char)v.b);          break;
    case 18: v.value = 0.04 * a * b;              v.unit = "mBar";    break;
    case 19: v.value = 0.01 * a * b;              v.unit = "l";       break;
    case 20: v.value = a * (b - 128) / 128.0;     v.unit = "%";       break;
    case 21: v.value = 0.001 * a * b;             v.unit = "V";       break;
    case 22: v.value = 0.001 * a * b;             v.unit = "ms";      break;
    case 23: v.value = b / 256.0 * a;             v.unit = "%";       break;
    case 24: v.value = 0.001 * a * b;             v.unit = "A";       break;
    case 25: v.value = (b * 1.421) + (a / 182.0); v.unit = "g/s";     break;
    case 26: v.value = b - a;                     v.unit = "C";       break;
    case 27: v.value = fabs(b - 128) * 0.01 * a;
             v.unit  = (v.b < 128) ? "ATDC" : "BTDC";                break;
    case 28: v.value = b - a;                     v.unit = "";        break;
    case 29: v.isText = true;
             v.text = (v.b < v.a) ? "1.Kennfeld" : "2.Kennfeld";      break;
    case 30: v.value = b / 12.0 * a;              v.unit = "Deg k/w"; break;
    case 31: v.value = b / 2560.0 * a;            v.unit = "C";       break;
    case 32: v.value = (v.b > 128) ? (b - 256) : b; v.unit = "";      break;
    case 33: v.value = (v.a == 0) ? (100 * b) : (100 * b / a);
             v.unit  = "%";                                           break;
    case 34: v.value = (b - 128) * 0.01 * a;      v.unit = "kW";      break;
    case 35: v.value = 0.01 * a * b;              v.unit = "l/h";     break;
    case 36: v.value = a * 2560 + b * 10;         v.unit = "km";      break;
    case 37: v.isText = true; v.value = v.b;
             v.text = "Oil Pr. 2 < min";                              break;
    case 38: v.value = (b - 128) * 0.001 * a;     v.unit = "Deg k/w"; break;
    case 39: v.value = b / 256.0 * a;             v.unit = "mg/Hub";  break;
    case 40: v.value = b * 0.1 + (25.5 * a) - 400; v.unit = "A";      break;
    case 41: v.value = b + a * 255;               v.unit = "Ah";      break;
    case 42: v.value = b * 0.1 + (25.5 * a) - 400; v.unit = "kW";     break;
    case 43: v.value = b * 0.1 + (25.5 * a);      v.unit = "V";       break;
    case 44: v.isText = true;
             v.text = String(v.a) + ":" + (v.b < 10 ? "0" : "") + String(v.b);
             v.unit = "h:m";                                          break;
    case 45: v.value = 0.1 * a * b / 100.0;       v.unit = "";        break;
    case 46: v.value = (a * b - 3200) * 0.0027;   v.unit = "Deg k/w"; break;
    case 47: v.value = (b - 128) * a;             v.unit = "ms";      break;
    case 48: v.value = b + a * 255;               v.unit = "";        break;
    case 49: v.value = (b / 4.0) * a * 0.1;       v.unit = "mg/Hub";  break;
    case 50: v.value = (v.a == 0) ? ((b - 128) / 0.01)
                                  : ((b - 128) / (0.01 * a));
             v.unit  = "mBar";                                        break;
    case 51: v.value = ((b - 128) / 255.0) * a;   v.unit = "mg/Hub";  break;
    case 52: v.value = b * 0.02 * a - a;          v.unit = "Nm";      break;
    case 53: v.value = (b - 128) * 1.4222 + 0.006 * a; v.unit = "g/s"; break;
    case 54: v.value = a * 256 + b;               v.unit = "Count";   break;
    case 55: v.value = a * b / 200.0;             v.unit = "s";       break;
    case 56: v.value = a * 256 + b;               v.unit = "WSC";     break;
    case 57: v.value = a * 256 + b + 65536;       v.unit = "WSC";     break;
    case 58: v.value = (v.b > 128) ? (1.0225 * (256 - b)) : (1.0225 * b);
             v.unit  = "/s";                                          break;
    case 59: v.value = (a * 256 + b) / 32768.0;   v.unit = "";        break;
    case 60: v.value = (a * 256 + b) * 0.01;      v.unit = "s";       break;
    case 61: v.value = (v.a == 0) ? (b - 128) : ((b - 128) / a);
             v.unit  = "";                                            break;
    case 62: v.value = 0.256 * a * b;             v.unit = "S";       break;
    case 63: v.isText = true;
             v.text = String((char)v.a) + String((char)v.b) + "?";   break;
    case 64: v.value = a + b;                     v.unit = "Ohm";     break;
    case 65: v.value = 0.01 * a * (b - 127);      v.unit = "mm";      break;
    case 66: v.value = (a * b) / 511.12;          v.unit = "V";       break;
    case 67: v.value = (640 * a) + b * 2.5;       v.unit = "Deg";     break;
    case 68: v.value = (256 * a + b) / 7.365;     v.unit = "deg/s";   break;
    case 69: v.value = (256 * a + b) * 0.3254;    v.unit = "bar";     break;
    case 70: v.value = (256 * a + b) * 0.192;     v.unit = "m/s2";    break;

    default:
      // Unbekannte Kennzahl: Rohwert b zurueckgeben
      v.value = b;
      v.unit  = "?";
      break;
  }
}


// =====================================================
// MESSWERTBLOCK KOMPLETT LESEN
//
// Anfrage:  04 ZZ 29 GG 03
// Antwort:  LL ZZ E7 [K a b] x max. 4  03
// =====================================================

bool readMeasurementGroup(
  uint8_t group,
  KwpValue values[],
  uint8_t &fieldCount,
  bool printAllFields) {

  fieldCount = 0;

  for (uint8_t i = 0; i < KWP_MAX_FIELDS; i++) {
    values[i].valid = false;
  }

  if (!kwpConnected) {
    Serial.println("FEHLER: Keine aktive Verbindung.");
    return false;
  }

  uint8_t request[5];
  request[0] = 0x04;
  request[1] = blockCounter;
  request[2] = 0x29;
  request[3] = group;
  request[4] = 0x03;

  if (!kwpSendBlock(request, sizeof(request))) {
    Serial.print("FEHLER: Group Reading MWB ");
    Serial.print(group);
    Serial.println(" konnte nicht gesendet werden.");
    return false;
  }

  uint8_t response[64];
  uint16_t responseSize = 0;

  if (!kwpReceiveBlock(response, sizeof(response), responseSize)) {
    Serial.print("FEHLER: Keine Antwort auf MWB ");
    Serial.println(group);
    return false;
  }

  if (response[2] == 0x0A) {
    Serial.println("FEHLER: MSG meldet No-Acknowledge.");
    return false;
  }

  if (response[2] != 0xE7) {
    Serial.print("FEHLER: Antworttitel ist 0x");
    printHex(response[2]);
    Serial.println(", erwartet wurde 0xE7.");
    return false;
  }

  uint16_t dataBytes = responseSize - 4;

  if (dataBytes == 0 || (dataBytes % 3) != 0) {
    Serial.println("FEHLER: Datenformat ist ungueltig.");
    return false;
  }

  uint16_t count = dataBytes / 3;
  if (count > KWP_MAX_FIELDS) {
    count = KWP_MAX_FIELDS;
  }

  for (uint8_t f = 0; f < count; f++) {
    uint16_t pos = 3 + (f * 3);

    values[f].formula = response[pos];
    values[f].a       = response[pos + 1];
    values[f].b       = response[pos + 2];

    decodeKwpValue(values[f]);
    values[f].valid = true;
  }

  fieldCount = (uint8_t)count;

  if (printAllFields) {
    Serial.println();
    Serial.print("MWB ");
    Serial.print(group);
    Serial.print(" RAW: ");
    for (uint16_t i = 0; i < responseSize; i++) {
      printHex(response[i]);
      Serial.print(" ");
    }
    Serial.println();

    for (uint8_t f = 0; f < fieldCount; f++) {
      Serial.print("Feld ");
      Serial.print(f + 1);
      Serial.print("  K=");
      Serial.print(values[f].formula);
      Serial.print("  a=");
      Serial.print(values[f].a);
      Serial.print("  b=");
      Serial.print(values[f].b);
      Serial.print("  -> ");

      if (values[f].isText) {
        Serial.print(values[f].text);
      } else {
        Serial.print(values[f].value, 2);
      }

      Serial.print(" ");
      Serial.println(values[f].unit);
    }
  }

  return true;
}

// =====================================================
// LADEDRUCK ALS UEBERDRUCK LESEN
//
// MWB 010 Feld 3 = Ladedruck (absolut)
// MWB 010 Feld 2 = Atmosphaerischer Druck
// Ueberdruck     = Feld 3 - Feld 2   [mBar]
// =====================================================

bool readBoostOverpressure() {
  KwpValue g10[KWP_MAX_FIELDS];
  uint8_t n = 0;

  if (!readMeasurementGroup(10, g10, n, false) || n < 3) {
    return false;
  }

  float overpressure =
    (float)g10[2].value - (float)g10[1].value;

  // Im Leerlauf kann es leicht negativ sein -> 0 anzeigen
  if (overpressure < 0.0f) {
    overpressure = 0.0f;
  }

  lastBoostMbar = (uint16_t)(overpressure + 0.5f);

  return true;
}

// =====================================================
// EINZELNEN MESSWERT LESEN
//
// group = Messwertblock (z.B. 1, 6, 11)
// field = Feld 1..4
// =====================================================

bool readMeasurement(
  uint8_t group,
  uint8_t field,
  KwpValue &out,
  bool printAllFields) {

  out.valid = false;

  if (field < 1 || field > KWP_MAX_FIELDS) {
    Serial.println("FEHLER: Feld muss 1 bis 4 sein.");
    return false;
  }

  KwpValue values[KWP_MAX_FIELDS];
  uint8_t fieldCount = 0;

  if (!readMeasurementGroup(group, values, fieldCount, printAllFields)) {
    return false;
  }

  if (field > fieldCount) {
    Serial.print("FEHLER: MWB ");
    Serial.print(group);
    Serial.print(" hat kein Feld ");
    Serial.println(field);
    return false;
  }

  out = values[field - 1];
  return true;
}



// =====================================================
// KRAFTSTOFF PRO STUNDE (L/h)
// 5-Zylinder, 4-Takt: 2,5 Einspritzungen pro Umdrehung
// Dieseldichte ca. 0,832 kg/L
// =====================================================

float calculateLitersPerHour(uint16_t rpm, float injection) {
  const float INJECTIONS_PER_REV = 2.5f;
  const float DIESEL_DENSITY_MG_PER_L = 832000.0f;

  float mgPerMinute =
    injection * (float)rpm * INJECTIONS_PER_REV;

  return (mgPerMinute / DIESEL_DENSITY_MG_PER_L) * 60.0f;
}

void calculateFuelConsumption() {

  float litersPerHour =
    calculateLitersPerHour(lastRpm, injectionActual);

  // -------------------------------------------------
  // BEI FAHRZEUGSTILLSTAND ZURUECKSETZEN
  // Wichtig: vor dem Eintragen in den Puffer prüfen.
  // -------------------------------------------------

  if (currentSpeed < 4.0f) {

    fuelConsumption = 0.0f;

    for (uint8_t i = 0; i < FUEL_AVG_SAMPLES; i++) {
      fuelHourBuf[i] = 0.0f;
      speedBuf[i] = 0.0f;
    }

    fuelBufCount = 0;
    fuelBufIndex = 0;

    Serial.print("Verbrauch: ");
    Serial.print(litersPerHour, 2);
    Serial.println(" L/h roh | 0.0 L/100km, Fahrzeug steht");

    return;
  }

  // -------------------------------------------------
  // AKTUELLEN WERT IN DEN RINGPUFFER SCHREIBEN
  // -------------------------------------------------

  fuelHourBuf[fuelBufIndex] = litersPerHour;
  speedBuf[fuelBufIndex] = currentSpeed;

  fuelBufIndex =
    (fuelBufIndex + 1) % FUEL_AVG_SAMPLES;

  if (fuelBufCount < FUEL_AVG_SAMPLES) {
    fuelBufCount++;
  }

  // -------------------------------------------------
  // MITTELWERTE BILDEN
  // -------------------------------------------------

  float sumFuel = 0.0f;
  float sumSpeed = 0.0f;

  for (uint8_t i = 0; i < fuelBufCount; i++) {
    sumFuel += fuelHourBuf[i];
    sumSpeed += speedBuf[i];
  }

  float avgFuelHour =
    sumFuel / (float)fuelBufCount;

  float avgSpeed =
    sumSpeed / (float)fuelBufCount;

  // -------------------------------------------------
  // VERBRAUCH BERECHNEN
  //
  // Unter 10 km/h Durchschnittsgeschwindigkeit wird
  // 0.0 angezeigt, damit beim Losfahren keine Werte
  // wie 50 bis 70 L/100km auftreten.
  // -------------------------------------------------

  if (avgSpeed < 10.0f) {

    fuelConsumption = 0.0f;

  } else {

    fuelConsumption =
      avgFuelHour * 100.0f / avgSpeed;
  }

  // -------------------------------------------------
  // SERIELLE AUSGABE
  // -------------------------------------------------

  Serial.print("Verbrauch: ");
  Serial.print(litersPerHour, 2);
  Serial.print(" L/h roh | ");

  Serial.print(fuelConsumption, 1);
  Serial.print(" L/100km geglaettet | ");

  Serial.print("Geschwindigkeit aktuell: ");
  Serial.print(currentSpeed, 1);
  Serial.print(" km/h | Mittel: ");
  Serial.print(avgSpeed, 1);
  Serial.println(" km/h");
}

// =====================================================
// FAHRT-DURCHSCHNITT AUFSUMMIEREN
//
// Durchschnitt = Gesamtliter / Gesamtkilometer * 100
// Standzeiten (< 4 km/h) werden nicht gezählt.
// =====================================================

void updateAverageFuelConsumption(float litersPerHour, float speedKmh) {

  uint32_t now = millis();

  // Erster Aufruf oder nach Pause: nur Zeitstempel setzen
  if (lastAverageUpdateTime == 0) {
    lastAverageUpdateTime = now;
    return;
  }

  uint32_t elapsedMs = now - lastAverageUpdateTime;
  lastAverageUpdateTime = now;

  // Lücken > 10 s ignorieren (Spannungsmodus, Fehlerspeicher,
  // Verbindungsabbruch) -> keine Sprünge
  if (elapsedMs == 0 || elapsedMs > 10000UL) {
    return;
  }

  // Standzeit nicht berücksichtigen
  if (speedKmh < FUEL_MIN_SPEED_KMH || litersPerHour < 0.0f) {
    return;
  }

  double hours = (double)elapsedMs / 3600000.0;

  tripFuelLiters += (double)litersPerHour * hours;
  tripDistanceKm += (double)speedKmh * hours;

  if (tripDistanceKm >= AVERAGE_MIN_DISTANCE_KM) {
    averageFuelConsumption =
      (float)(tripFuelLiters * 100.0 / tripDistanceKm);
  }

  Serial.print("Fahrt: ");
  Serial.print(tripDistanceKm, 3);
  Serial.print(" km | ");
  Serial.print(tripFuelLiters, 4);
  Serial.print(" L | AVG ");
  Serial.print(averageFuelConsumption, 1);
  Serial.println(" L/100km");
}

// =====================================================
// MWB 1 + MWB 6 FÜR DEN DURCHSCHNITT LESEN
// (wird in Modi ohne Verbrauchsanzeige alle 2 s genutzt)
// =====================================================

bool readTripAverageValues() {
  KwpValue g1[KWP_MAX_FIELDS];
  uint8_t n = 0;
  KwpValue speedValue;

  if (!readMeasurementGroup(1, g1, n, false) || n < 2) {
    return false;
  }

  uint16_t rpm = (uint16_t)g1[0].value;
  float injection = (float)g1[1].value;

  if (!readMeasurement(6, 1, speedValue, false)) {
    return false;
  }

  // Frische Werte gleich mit übernehmen
  lastRpm = rpm;
  injectionActual = injection;

  updateAverageFuelConsumption(
    calculateLitersPerHour(rpm, injection),
    (float)speedValue.value);

  return true;
}

// =====================================================
// OLED - NORMALE MESSWERTANZEIGE
// =====================================================

void oledShowValue(String value, String unit) {
  display.clearDisplay();
  display.setTextColor(SSD1306_WHITE);

  display.setTextSize(2);
  display.setCursor(getCenteredX(value), 23);
  display.print(value);

  display.setTextSize(1);
  display.setCursor(getCenteredX(unit), 40);
  display.print(unit);

  display.display();
}

void oledShowNormal() {
  if (displayMode == MODE_BOOST) {
    oledShowValue(String(lastBoostMbar), baseUnits[SCR_BOOST]);
  } else if (displayMode == MODE_CONSUMPTION) {
    oledShowValue(String(fuelConsumption, 1), baseUnits[SCR_CONSUMPTION]);
  } else if (displayMode == MODE_AVERAGE_CONSUMPTION) {
    oledShowValue(String(averageFuelConsumption, 1), baseUnits[SCR_AVERAGE]);
  } else if (displayMode == MODE_CUSTOM) {
    oledShowCustom();
  }
}

// Eigener Messwert: oben Wert, darunter Kurzname (oder Einheit)
void oledShowCustom() {
  CustomScreen &c = customScreens[activeCustom];

  String unitText = strlen(c.unit) > 0
                      ? String(c.unit)
                      : customUnitText;

  display.clearDisplay();
  display.setTextColor(SSD1306_WHITE);

  // Lange Texte, zum Beispiel Bitmuster, kleiner darstellen
  display.setTextSize(customValueText.length() <= 5 ? 2 : 1);
  display.setCursor(getCenteredX(customValueText), 23);
  display.print(customValueText);

  // Eigene beziehungsweise automatisch ermittelte Einheit
  display.setTextSize(1);
  display.setCursor(getCenteredX(unitText), 40);
  display.print(unitText);

  display.display();
}

// =====================================================
// OLED - CODEBLOCK MODUS
// =====================================================

void oledShowCodeblock() {
  display.clearDisplay();
  display.setTextColor(SSD1306_WHITE);

  // -------------------------------------------------
  // CB: 2 / CB: 3
  // -------------------------------------------------

  display.setTextSize(1);

  String title = "CB: " + String(currentCodeblock);

  int16_t tx = getCenteredX(title);

  display.setCursor(tx, 9);
  display.print(title);

  // -------------------------------------------------
  // LEISTUNG
  // -------------------------------------------------

  String power;

  if (currentCodeblock == 2) {
    power = "102PS";
  } else if (currentCodeblock == 3) {
    power = "138PS";
  } else {
    power = "???";
  }

  display.setTextSize(2);

  tx = getCenteredX(power);

  display.setCursor(tx, 24);
  display.print(power);

  display.display();
}

// =====================================================
// OLED - SCHREIBEN
// =====================================================

void oledShowWriting() {
  display.clearDisplay();
  display.setTextColor(SSD1306_WHITE);

  display.setTextSize(1);

  display.setCursor(0, 24);
  display.println("CODEBLOCK");


  display.setCursor(0, 36);
  display.println("Schreiben");

  display.display();
}


// =====================================================
// OLED - ERFOLG
// =====================================================

void oledShowSuccess() {
  display.clearDisplay();
  display.setTextColor(SSD1306_WHITE);

  display.setTextSize(1);

  display.setCursor(0, 12);
  display.println("CODEBLOCK");

  display.setCursor(0, 23);
  display.println("erfolgreich");

  display.setCursor(0, 34);
  display.println("geschrieben!");

  display.display();

  delay(1500);
}


// =====================================================
// OLED - FEHLER
// =====================================================

void oledShowError() {
  display.clearDisplay();
  display.setTextColor(SSD1306_WHITE);

  display.setTextSize(1);

  display.setCursor(0, 20);
  display.println("FEHLER!");

  display.setCursor(0, 28);
  display.println("Vorgang");

  display.setCursor(0, 35);
  display.println("fehlgeschlagen");

  display.display();

  delay(1500);
}

// =====================================================
// SPANNUNG MESSEN
// =====================================================

const int VOLTAGE_PIN = 0;

// Spannungsteiler
const float R_TOP = 47000000.0;
const float R_BOTTOM = 10000000.0;

// Korrekturwert in V - in der WebApp unter Einstellungen änderbar
const float DEFAULT_VOLTAGE_OFFSET = 0.0f;
float voltageOffset = DEFAULT_VOLTAGE_OFFSET;

// Messung
const int NUM_SAMPLES = 50;
const unsigned long VOLTAGE_DISPLAY_TIME = 500;

unsigned long lastVoltageDisplay = 0;

float measuredVoltage = 0.0;

// =====================================================
// SPANNUNG NUR MESSEN (ohne OLED)
// =====================================================

void measureVoltage() {
  long adcSum = 0;

  for (int i = 0; i < NUM_SAMPLES; i++) {
    adcSum += analogRead(VOLTAGE_PIN);
    delayMicroseconds(500);
  }

  float adcValue = adcSum / (float)NUM_SAMPLES;
  float adcVoltage = (adcValue / 4095.0) * 3.3;

  measuredVoltage =
    adcVoltage * ((R_TOP + R_BOTTOM) / R_BOTTOM);

  measuredVoltage += voltageOffset;
}

// =====================================================
// OLED - HINWEIS "X FSP gefunden"
// =====================================================

void oledShowFspNotice() {
  display.clearDisplay();
  display.setTextColor(SSD1306_WHITE);

  // Max. 9 Fehler -> "X FSP" passt immer in Größe 2
  String line1 = String(faultCount) + " FSP";

  display.setTextSize(1);
  display.setCursor(getCenteredX(line1), 24);
  display.print(line1);

  display.setTextSize(1);
  String line2 = "gefunden";
  display.setCursor(getCenteredX(line2), 36);
  display.print(line2);

  display.display();
}


// =====================================================
// SPANNUNG MESSEN UND ANZEIGEN
// =====================================================

void updateVoltageDisplay() {

  if (displayMode != MODE_VOLTAGE) {
    return;
  }

  if (millis() - lastVoltageDisplay < VOLTAGE_DISPLAY_TIME) {
    return;
  }

  lastVoltageDisplay = millis();

  // Diagnose aus -> Hinweis statt Spannung (Spannung fürs Web weiter messen)
  if (diagDisabled) {
    measureVoltage();
    oledShowValue("Diag", "aus");
    return;
  }

  // FSP-Hinweis hat für 10 s Vorrang vor der Spannung
  if (fspNoticeActive) {
    if (millis() - fspNoticeStart < FSP_NOTICE_MS) {
      oledShowFspNotice();
      return;
    }
    fspNoticeActive = false;
  }

  measureVoltage();

  // ------------------------------------------
  // Serieller Monitor
  // ------------------------------------------

  Serial.print("Spannung: ");
  Serial.print(measuredVoltage, 2);
  Serial.println(" V");

  // ------------------------------------------
  // OLED
  // ------------------------------------------

  display.clearDisplay();
  display.setTextColor(SSD1306_WHITE);




  // ----------------------------------------
  // Spannung
  // ----------------------------------------


  String voltageText = String(measuredVoltage, 1);

  if (strlen(baseUnits[SCR_VOLTAGE]) > 0) {
    voltageText += " ";
    voltageText += baseUnits[SCR_VOLTAGE];
  }

  // Eigene GFX-Schrift aktivieren
  display.setFont(&FreeSans9pt7b);
  display.setTextSize(1);

  // Schrift zentrieren
  int16_t x1, y1;
  uint16_t w, h;

  display.getTextBounds(
    voltageText,
    0,
    0,
    &x1,
    &y1,
    &w,
    &h);

  int x = (64 - w) / 2;

  // Bei GFX-Fonts ist die Y-Position die Baseline
  display.setCursor(x, 43);
  display.print(voltageText);

  // Danach wieder Standardschrift verwenden
  display.setFont(NULL);

  display.display();
}

// =====================================================
// OLED-KONFIGURATION: LADEN / SPEICHERN / ANZEIGEN
// =====================================================

bool screenValid(int id) {
  // Drehzahl und Einspritzmenge entfallen (über eigene Messwerte möglich)
  if (id == SCR_RPM || id == SCR_INJECTION) return false;

  if (id >= SCR_VOLTAGE && id <= SCR_INJECTION) return true;

  if (id >= SCR_CUSTOM1 && id < SCR_CUSTOM1 + MAX_CUSTOM) {
    return customScreens[id - SCR_CUSTOM1].group != 0;
  }

  return false;
}

void loadOledConfig() {
  memset(customScreens, 0, sizeof(customScreens));
  memcpy(baseUnits, DEFAULT_UNITS, sizeof(baseUnits));

  prefs.begin("oled", true);

  size_t n = prefs.getBytesLength("list");
  if (n > 0 && n <= MAX_SCREENS) {
    prefs.getBytes("list", screenList, n);
    screenCount = n;
  }

  if (prefs.getBytesLength("custom") == sizeof(customScreens)) {
    prefs.getBytes("custom", customScreens, sizeof(customScreens));
  }

  if (prefs.getBytesLength("units") == sizeof(baseUnits)) {
    prefs.getBytes("units", baseUnits, sizeof(baseUnits));
  }

  prefs.end();

  // Ungültige Einträge entfernen
  uint8_t w = 0;
  for (uint8_t i = 0; i < screenCount; i++) {
    if (screenValid(screenList[i])) {
      screenList[w++] = screenList[i];
    }
  }
  screenCount = w;

  if (screenCount == 0) {
    screenList[0] = SCR_VOLTAGE;
    screenCount = 1;
  }

  Serial.print("OLED-Konfiguration geladen, Bildschirme: ");
  Serial.println(screenCount);
}

void saveOledConfig() {
  prefs.begin("oled", false);
  prefs.putBytes("list", screenList, screenCount);
  prefs.putBytes("custom", customScreens, sizeof(customScreens));
  prefs.putBytes("units", baseUnits, sizeof(baseUnits));
  prefs.end();

  Serial.println("OLED-Konfiguration gespeichert.");
}

// Messwert als Text: ab 100 ohne, darunter mit 1 Nachkommastelle
String formatMeasurement(bool isText, const String &text, double value) {
  if (isText) {
    return text;
  }
  if (fabs(value) >= 100.0) {
    return String(value, 0);
  }
  return String(value, 1);
}

void setCustomValue(bool isText, const String &text, double value, const String &unit) {
  customValueText = formatMeasurement(isText, text, value);
  customUnitText = unit;

  customLive[activeCustom] = customValueText;
  customLiveUnit[activeCustom] = unit;
}

// Steht der Bildschirm in der OLED-Liste?
bool screenInList(uint8_t id) {
  for (uint8_t i = 0; i < screenCount; i++) {
    if (screenList[i] == id) return true;
  }
  return false;
}

// =====================================================
// WEB-DASHBOARD: EIGENE MESSWERTE REIHUM LESEN
// Pro Messzyklus ein Block, alle eigenen Messwerte aus
// diesem Block werden gleich mit übernommen.
// =====================================================

uint8_t webCustomCursor = 0;

bool readNextWebCustom() {
  for (uint8_t k = 0; k < screenCount; k++) {
    uint8_t i = (webCustomCursor + k) % screenCount;
    uint8_t id = screenList[i];

    if (id < SCR_CUSTOM1 || id >= SCR_CUSTOM1 + MAX_CUSTOM) continue;

    uint8_t slot = id - SCR_CUSTOM1;

    // Den Wert am OLED liest der Messzyklus ohnehin
    if (displayMode == MODE_CUSTOM && slot == activeCustom) continue;

    webCustomCursor = i + 1;

    uint8_t group = customScreens[slot].group;
    KwpValue vals[KWP_MAX_FIELDS];
    uint8_t n = 0;

    if (!readMeasurementGroup(group, vals, n, false)) {
      customLive[slot] = "-";
      return false;
    }

    for (uint8_t s = 0; s < MAX_CUSTOM; s++) {
      CustomScreen &o = customScreens[s];
      if (o.group == group && o.field >= 1 && o.field <= n) {
        KwpValue &f = vals[o.field - 1];
        customLive[s] = formatMeasurement(f.isText, f.text, f.value);
        customLiveUnit[s] = f.unit;
      }
    }
    return true;
  }

  // Keine weiteren eigenen Messwerte in der Liste
  return true;
}

// Bildschirm aktivieren
void applyScreen(uint8_t id) {
  // Diagnose aus -> immer Spannungsbildschirm (auch bei Web-Änderungen)
  if (diagDisabled) {
    id = SCR_VOLTAGE;
    screenIndex = 0;
    for (uint8_t i = 0; i < screenCount; i++) {
      if (screenList[i] == SCR_VOLTAGE) screenIndex = i;
    }
  }

  currentScreenId = id;
  lastVoltageDisplay = 0;

  switch (id) {
    case SCR_VOLTAGE:
      displayMode = MODE_VOLTAGE;
      Serial.println("MODE: SPANNUNG");
      updateVoltageDisplay();
      return;

    case SCR_BOOST:       displayMode = MODE_BOOST;               break;
    case SCR_CONSUMPTION: displayMode = MODE_CONSUMPTION;         break;
    case SCR_AVERAGE:     displayMode = MODE_AVERAGE_CONSUMPTION; break;


    default:
      displayMode = MODE_CUSTOM;
      activeCustom = id - SCR_CUSTOM1;
      customValueText = "-";
      customUnitText = "";
      break;
  }

  Serial.print("MODE-ID: ");
  Serial.println(id);

  oledShowNormal();
}

// Nach Änderung: aktuellen Bildschirm in neuer Liste wiederfinden
void syncScreenIndex() {
  if (displayMode == MODE_CODEBLOCK) return;

  for (uint8_t i = 0; i < screenCount; i++) {
    if (screenList[i] == currentScreenId &&
        screenValid(currentScreenId)) {
      screenIndex = i;
      return;
    }
  }

  // Aktueller Bildschirm wurde entfernt/gelöscht -> ersten anzeigen
  screenIndex = 0;
  applyScreen(screenList[0]);
}

// =====================================================
// CODEBLOCK-MODUS ÖFFNEN
// =====================================================

void enterCodeblockMode() {
  Serial.println();
  Serial.println("========================================");
  Serial.println("        CODEBLOCK MODUS");
  Serial.println("========================================");

  displayMode = MODE_CODEBLOCK;


  // -------------------------------------------------
  // Verbindung herstellen
  // -------------------------------------------------

  if (!kwpConnected) {
    if (lastConnectAttempt != 0 &&
        millis() - lastConnectAttempt < RECONNECT_PAUSE_MS) {
      oledShowValue("CB ?", "kein MSG");
      return;
    }

    bool ok = connectMSG(1);
    lastConnectAttempt = ok ? 0 : millis();

    if (!ok) {
      oledShowValue("CB ?", "kein MSG");
      return;
    }
  }
  // -------------------------------------------------
  // Aktuelle Codierung übernehmen
  // -------------------------------------------------

  currentCodeblock = Coding;

  // Nur 2 und 3 erlauben
  if (currentCodeblock != 2 && currentCodeblock != 3) {
    Serial.print("Unbekannter Codeblock: ");
    Serial.println(currentCodeblock);

    currentCodeblock = 2;
  }

  Serial.print("Aktueller Codeblock: ");
  Serial.println(currentCodeblock);

  // Verbindung nicht offen halten.
  // changeCodeblock() verbindet bei Bedarf neu.
  disconnectMSG();

  oledShowCodeblock();
}
// =====================================================
// CODEBLOCK 2 <-> 3
// =====================================================

void changeCodeblock() {

  if (displayMode != MODE_CODEBLOCK) {
    return;
  }

  oledShowWriting();

  // =====================================================
  // ZIEL BESTIMMEN
  // =====================================================

  uint16_t newCodeblock;

  if (currentCodeblock == 2) {
    newCodeblock = 3;
  } else {
    newCodeblock = 2;
  }

  Serial.println();
  Serial.println("========================================");
  Serial.println("       CODEBLOCK WECHSEL");
  Serial.println("========================================");

  Serial.print("Aktuell: ");
  Serial.println(currentCodeblock);

  Serial.print("Neu:     ");
  Serial.println(newCodeblock);

  // =====================================================
  // WICHTIG:
  // ALTE KWP-VERBINDUNG IMMER BEENDEN
  // =====================================================

  if (kwpConnected) {

    Serial.println();
    Serial.println("Beende alte KWP-Verbindung...");

    disconnectMSG();
  }

  // =====================================================
  // KURZ WARTEN
  // =====================================================

  delay(100);

  // =====================================================
  // NEU MIT MSG VERBINDEN
  // =====================================================

  Serial.println();
  Serial.println("Verbinde MSG fuer Codeblock-Schreiben...");

  if (!connectMSG()) {

    Serial.println();
    Serial.println("FEHLER: Verbindung zum MSG fehlgeschlagen.");

    oledShowError();
    return;
  }

  Serial.println();
  Serial.println("MSG erneut verbunden.");

  Serial.print("Aktuelle Codierung: ");
  Serial.println(Coding);

  Serial.print("Aktueller WSC: ");
  Serial.println(WSC);
  
    // Ziel immer aus der gerade gelesenen Codierung bestimmen
  if (Coding != 2 && Coding != 3) {
    Serial.println("FEHLER: Unbekannte Codierung, es wird nichts geschrieben.");
    disconnectMSG();
    oledShowError();
    oledShowValue("CB ?", "unbekannt");
    return;
  }

  currentCodeblock = Coding;
  newCodeblock = (Coding == 2) ? 3 : 2;

  Serial.print("Ziel (nach Neuverbindung): ");
  Serial.println(newCodeblock);

  // =====================================================
  // WSC ÜBERNEHMEN
  // =====================================================

  uint32_t unchangedWSC = WSC;

  // =====================================================
  // CODEBLOCK SCHREIBEN
  // =====================================================


  bool result = sendCoding(
    newCodeblock,
    unchangedWSC);

  // =====================================================
  // VERBINDUNG BEENDEN
  // =====================================================

  if (result) {

    disconnectMSG();

  } else {

    Serial.println();
    Serial.println("B13 fehlgeschlagen.");

    // Keine weitere B03-Kommunikation erzwingen,
    // wenn das MSG bereits nicht mehr antwortet.

    stopKLine(false);
    kwpConnected = false;
  }

  // =====================================================
  // ERGEBNIS
  // =====================================================

  if (result) {

    currentCodeblock = newCodeblock;

    Serial.println();
    Serial.println("========================================");
    Serial.print("Codeblock erfolgreich geändert auf: ");
    Serial.println(currentCodeblock);
    Serial.println("========================================");

    oledShowCodeblock();

  } else {

    Serial.println();
    Serial.println("Codeblock-Wechsel fehlgeschlagen.");

    oledShowError();

    // Alten Codeblock weiter anzeigen
    oledShowCodeblock();
  }
}


// =====================================================
// TASTER-TASK
// Fragt den Taster alle 5 ms ab, entprellt und legt
// jedes Ereignis in die Warteschlange.
// Langer Druck wird bereits während des Haltens ausgelöst.
// =====================================================

void buttonTask(void *param) {
  bool rawPressed    = (digitalRead(BUTTON_INPUT) == LOW);
  bool stablePressed = rawPressed;

  uint32_t lastRawChange = millis();
  uint32_t pressStart    = millis();

  // Beim Einschalten bereits gedrückt -> diesen Druck ignorieren
  bool longSent = stablePressed;
  bool diagSent = stablePressed;

  for (;;) {
    uint32_t now = millis();
    bool raw = (digitalRead(BUTTON_INPUT) == LOW);

    // Jede Pegeländerung startet die Entprellzeit neu
    if (raw != rawPressed) {
      rawPressed = raw;
      lastRawChange = now;
    }

    // Zustand erst übernehmen, wenn er stabil ist
    if (rawPressed != stablePressed &&
        (uint32_t)(now - lastRawChange) >= BUTTON_DEBOUNCE_MS) {

      stablePressed = rawPressed;

      if (stablePressed) {
        // Gedrückt
        pressStart = now;
        longSent = false;
        diagSent = false;
      } else if (!longSent) {
        // Losgelassen vor langem Druck -> kurzer Druck
        ButtonEvent ev = BTN_SHORT;
        xQueueSend(buttonQueue, &ev, 0);
      }
    }

    // Langer Druck (Std. 3 s): sofort auslösen, nicht erst beim Loslassen
    if (stablePressed && !longSent &&
        (uint32_t)(now - pressStart) >= buttonLongPressMs) {

      ButtonEvent ev = BTN_LONG;
      xQueueSend(buttonQueue, &ev, 0);
      longSent = true;
    }

    // Sehr langer Druck (Std. 5 s): zusätzlich (Diagnose aus/an)
    if (stablePressed && !diagSent &&
        (uint32_t)(now - pressStart) >= buttonDiagPressMs) {

      ButtonEvent ev = BTN_DIAG;
      xQueueSend(buttonQueue, &ev, 0);
      diagSent = true;
    }

    vTaskDelay(pdMS_TO_TICKS(BUTTON_POLL_MS));
  }
}

// =====================================================
// TASTER AUSWERTEN
//
// KURZ:
//   Spannung       -> Drehzahl
//   Drehzahl       -> Ladedruck
//   Ladedruck      -> Verbrauch
//   Verbrauch      -> Einspritzmenge
//   Einspritzmenge -> Codeblock
//   Codeblock      -> Spannung
//
// LANG:
//   Im Codeblock-Modus:
//   Codeblock 2 <-> 3
//
// 5 s:
//   Im Spannungsmodus: Diagnose aus <-> an
//   Bei Diagnose aus wird alles andere ignoriert.
// =====================================================

// Diagnose ein-/ausschalten und im Flash speichern
void setDiagnosisDisabled(bool off) {
  diagDisabled = off;

  prefs.begin("diag", false);
  prefs.putBool("off", off);
  prefs.end();

  if (off) {
    Serial.println("DIAGNOSE AUS - K-Line frei");

    // Offene Anfragen verwerfen, Verbindung sauber beenden (B03)
    pendingFaultRequest = FAULT_REQUEST_NONE;
    startupFaultCheck = false;
    fspNoticeActive = false;

    if (kwpConnected) {
      disconnectMSG();
    }
    faultStatusText = "Diagnose aus";
  } else {
    Serial.println("DIAGNOSE AN");

    // Nächster Messzyklus verbindet sofort neu
    lastConnectAttempt = 0;
    faultStatusText = "";
  }

  applyScreen(SCR_VOLTAGE);
}

void handleButton() {
  if (buttonQueue == nullptr) return;

  ButtonEvent ev;

  while (xQueueReceive(buttonQueue, &ev, 0) == pdTRUE) {

    // ===================================================
    // 5 S DRUCK -> DIAGNOSE AUS / AN
    // ===================================================
    if (ev == BTN_DIAG) {
      if (displayMode == MODE_VOLTAGE) {
        setDiagnosisDisabled(!diagDisabled);
      }
      continue;
    }

    // Diagnose aus -> kein Bildschirmwechsel, kein Codeblock
    if (diagDisabled) {
      continue;
    }

    // ===================================================
    // LANGER DRUCK
    // ===================================================
    if (ev == BTN_LONG) {
      Serial.println("LANGER DRUCK");

      if (displayMode == MODE_CODEBLOCK) {
        Serial.println("Wechsle Codeblock...");
        changeCodeblock();
      } else {
        Serial.println("Langer Druck ausserhalb Codeblock ignoriert.");
      }
      continue;
    }

    // ===================================================
    // KURZER DRUCK
    // ===================================================
    Serial.println("KURZER DRUCK");

    // Codeblock -> zurück zum ersten Bildschirm
    if (displayMode == MODE_CODEBLOCK) {
      if (kwpConnected) {
        disconnectMSG();
      }
      screenIndex = 0;
      applyScreen(screenList[0]);
      continue;
    }

    // Nächster Bildschirm aus der Liste
    screenIndex++;

    if (screenIndex >= screenCount) {
      Serial.println("MODE: CODEBLOCK");
      enterCodeblockMode();
    } else {
      applyScreen(screenList[screenIndex]);
    }
  }
}

// =====================================================
// MESSWERTE AUTOMATISCH AKTUALISIEREN
// =====================================================

void updateMeasurements() {

  bool webActive = webClientActive();
  
    // Tastendruck wartet -> erst im nächsten loop() ausführen
  if (buttonPending()) {
    return;
  }

  // Diagnose aus -> K-Line bleibt komplett frei
  if (diagDisabled) {
    updateVoltageDisplay();
    return;
  }

  // Fehlerspeicher-Seite offen -> keine Live-Messwerte auf der K-Line,
  // Spannungsanzeige am OLED läuft weiter
  if (faultPageActive()) {
    updateVoltageDisplay();
    return;
  }

  // =====================================================
  // SPANNUNG
  // =====================================================

  if (displayMode == MODE_VOLTAGE) {
    // Spannung kommt vom ADC. KWP läuft trotzdem weiter,
    // damit der Fahrt-Durchschnitt von Anfang an mitzählt.
    updateVoltageDisplay();
  }

  // =====================================================
  // CODEBLOCK -> nie für Web lesen
  // =====================================================

  if (displayMode == MODE_CODEBLOCK) {
    return;
  }

  // =====================================================
  // INTERVALL
  // =====================================================

  if (millis() - lastMeasurementTime < MEASUREMENT_INTERVAL_MS) {
    return;
  }

  lastMeasurementTime = millis();

  // Spannung für Web auch außerhalb des Spannungsmodus
  if (webActive && displayMode != MODE_VOLTAGE) {
    measureVoltage();
  }

  if (buttonPending()) {
    return;
  }

  // Verbindung herstellen (1 Versuch, danach 15 s Pause)
  if (!kwpConnected) {
    if (lastConnectAttempt != 0 &&
        millis() - lastConnectAttempt < RECONNECT_PAUSE_MS) {
      return;
    }

    lastConnectAttempt = millis();

    if (!connectMSG(1)) {
      return;
    }

    // Verbindung erfolgreich -> beim nächsten Abbruch sofort neu versuchen
    lastConnectAttempt = 0;
  }
  // =====================================================
  // MESSWERT LESEN
  // =====================================================

#if TESTBENCH_MODE

  lastRpm = 900;
  lastBoostMbar = 1000;
  injectionActual = 42.5;

  bool readOk = true;

#else
  bool readOk = false;
  kwpLinkError = false;


  KwpValue v;

  // ================================================
  // WEBSEITE OFFEN -> ALLE LIVEWERTE
  // MWB 001 Feld 1+2, MWB 010 Feld 2
  // ================================================

  if (webActive && mwbActive()) {
    // MWB-Seite offen: nur den gewählten Block lesen
    uint8_t n = 0;
    readOk = readMeasurementGroup(webMwbGroup, mwbData, n, false);
    if (readOk) {
      mwbCount = n;
      mwbDataGroup = webMwbGroup;
      mwbError = false;

      // OLED zeigt eigenen Messwert
      if (displayMode == MODE_CUSTOM) {
        CustomScreen &c = customScreens[activeCustom];

        if (c.group == webMwbGroup) {
          if (c.field <= n) {
            KwpValue &cv = mwbData[c.field - 1];
            setCustomValue(cv.isText, cv.text, cv.value, cv.unit);
          }
        } else if (readMeasurement(c.group, c.field, v, false)) {
          setCustomValue(v.isText, v.text, v.value, v.unit);
        }
      }
    } else {
      mwbCount = 0;
      mwbError = true;
    }
  }

  else if (webActive) {
    // Dashboard offen -> alle Werte der OLED-Liste lesen
    KwpValue g1[KWP_MAX_FIELDS];
    uint8_t n = 0;

    if (readMeasurementGroup(1, g1, n, false) && n >= 2) {
      lastRpm = (uint16_t)g1[0].value;
      injectionActual = (float)g1[1].value;
      readOk = true;

      // Ueberdruck = MWB 010 Feld 3 - Feld 2
      if (screenInList(SCR_BOOST) || displayMode == MODE_BOOST) {
        readOk = readBoostOverpressure();
      }
	  
      // OLED zeigt eigenen Messwert -> zusätzlich lesen
      if (readOk && displayMode == MODE_CUSTOM) {
        CustomScreen &c = customScreens[activeCustom];
        readOk = readMeasurement(c.group, c.field, v, false);
        if (readOk) {
          setCustomValue(v.isText, v.text, v.value, v.unit);
        }
      }

      // Weitere eigene Messwerte fürs Dashboard (einer pro Zyklus)
      if (readOk && !readNextWebCustom() && kwpLinkError) {
        readOk = false;
      }

      // Verbrauch im Dashboard oder am OLED -> zusätzlich Geschwindigkeit
      if (readOk &&
          (screenInList(SCR_CONSUMPTION) || displayMode == MODE_CONSUMPTION)) {
        readOk = readMeasurement(6, 1, v, false);
        if (readOk) {
          currentSpeed = (float)v.value;
          calculateFuelConsumption();

          updateAverageFuelConsumption(
            calculateLitersPerHour(lastRpm, injectionActual),
            currentSpeed);
          lastAverageMeasurementTime = millis();
        }
      }
    }
  }


  // ================================================
  //   -> MWB 010 Feld 2
  // ================================================

  else if (displayMode == MODE_BOOST) {
    // Ueberdruck = MWB 010 Feld 3 - Feld 2
    readOk = readBoostOverpressure();
  }

  // ================================================
  // VERBRAUCH -> MWB 001 Feld 1+2, MWB 006 Feld 1
  // ================================================

  else if (displayMode == MODE_CONSUMPTION) {
    KwpValue g1[KWP_MAX_FIELDS];
    uint8_t n = 0;

    if (readMeasurementGroup(1, g1, n, false) && n >= 2) {
      lastRpm = (uint16_t)g1[0].value;
      injectionActual = (float)g1[1].value;

      if (readMeasurement(6, 1, v, false)) {
        currentSpeed = (float)v.value;
        calculateFuelConsumption();

        updateAverageFuelConsumption(
          calculateLitersPerHour(lastRpm, injectionActual),
          currentSpeed);
        lastAverageMeasurementTime = millis();

        readOk = true;
      }
    }
  }

  // ================================================
  // DURCHSCHNITT -> Werte kommen aus Block 8d
  // ================================================

  else if (displayMode == MODE_AVERAGE_CONSUMPTION) {
    // Jeden Zyklus lesen -> Verbindung bleibt aktiv
    // und der Durchschnitt wird genauer
    readOk = readTripAverageValues();
    lastAverageMeasurementTime = millis();
  }

  // ================================================
  // EIGENER MESSWERT -> gespeicherter Block / Feld
  // ================================================

  else if (displayMode == MODE_CUSTOM) {
    CustomScreen &c = customScreens[activeCustom];
    readOk = readMeasurement(c.group, c.field, v, false);
    if (readOk) {
      setCustomValue(v.isText, v.text, v.value, v.unit);
    }
  }

  // ================================================
  // SPANNUNG -> nichts zu lesen, nur Fahrt-Durchschnitt (unten)
  // ================================================

  else if (displayMode == MODE_VOLTAGE) {
    readOk = true;
  }


  // ================================================
  // FAHRT-DURCHSCHNITT IN ALLEN ANDEREN MODI
  // Alle 2 s MWB 1 + MWB 6 zusätzlich lesen.
  // Nicht, wenn die freie MWB-Webseite offen ist.
  // Im Durchschnittsmodus selbst läuft es ebenfalls hierüber.
  // ================================================

  if (readOk &&
      !mwbActive() &&
	  !buttonPending() &&
      millis() - lastAverageMeasurementTime >=
        AVERAGE_MEASUREMENT_INTERVAL_MS) {

    lastAverageMeasurementTime = millis();

    if (!readTripAverageValues()) {
      // Verbindung vermutlich gestört -> wie gewohnt zurücksetzen
      readOk = false;
    }
  }

  if (!readOk) {

    // SG hat nur abgelehnt -> Verbindung behalten
    if (kwpConnected && !kwpLinkError) {
      Serial.println("SG hat Anfrage abgelehnt, Verbindung bleibt bestehen.");
      return;
    }

    Serial.println();
    Serial.println("Messwert fehlgeschlagen.");
    Serial.println("Verbindung wird zurueckgesetzt.");

    // Kein blockierendes Warten noetig, Reconnect-Pause ist 15 s
    stopKLine(false);
    kwpConnected = false;
    lastConnectAttempt = millis();

    // Spannungsanzeige nicht überschreiben
    if (displayMode != MODE_VOLTAGE) {
      oledShowValue("---", "kein MSG");
    }
    return;
  }

#endif

  // =====================================================
  // OLED (im Spannungsmodus macht oledShowNormal nichts)
  // =====================================================

  oledShowNormal();
}

// =====================================================
// CODEBLOCK-WECHSEL AUS DEM WEB ABARBEITEN
// =====================================================

volatile uint16_t pendingCodeblockTarget = 0;
bool codeblockCyclePending = false;   // Erfolg -> WebApp meldet Zündungswechsel
String codeblockError = "";

void processCodeblockRequest() {
  if (pendingCodeblockTarget == 0) return;

  uint16_t target = pendingCodeblockTarget;
  pendingCodeblockTarget = 0;

  Serial.print("WEB: Codeblock-Wechsel auf ");
  Serial.println(target);

  oledShowWriting();
  kwpLinkError = false;

  bool result = false;
  String error = "";

  // Schreiben wie am Taster: immer über eine frische Verbindung
  if (kwpConnected) {
    disconnectMSG();
  }
  delay(100);

  if (!connectMSG()) {
    error = "Keine Verbindung zum MSG";
  } else if (Coding != 2 && Coding != 3) {
    error = "Unbekannte Codierung, nichts geschrieben";
  } else if (Coding == target) {
    error = String(target == 2 ? "102" : "138") + " PS ist bereits aktiv";
  } else if (sendCoding(target, WSC)) {
    result = true;
  } else {
    error = "Schreiben fehlgeschlagen";
  }

  // Bei Fehlern keine weitere Kommunikation erzwingen
  if (result) {
    disconnectMSG();
  } else if (kwpConnected) {
    stopKLine(false);
    kwpConnected = false;
  }

  lastConnectAttempt = millis();
  lastMeasurementTime = millis();

  if (Coding == 2 || Coding == 3) {
    currentCodeblock = Coding;
  }

  codeblockCyclePending = result;
  codeblockError = error;

  if (!result) {
    Serial.print("WEB: Codeblock-Wechsel fehlgeschlagen: ");
    Serial.println(error);
    oledShowError();
  }

  // OLED wieder wie vorher
  if (displayMode == MODE_CODEBLOCK) {
    oledShowCodeblock();
  } else {
    applyScreen(currentScreenId);
  }
}

// =====================================================
// FEHLERSPEICHER-ANFORDERUNG AUS DEM WEB ABARBEITEN
// =====================================================

void processFaultRequest() {
  if (pendingFaultRequest == FAULT_REQUEST_NONE) return;

  FaultRequestType request = pendingFaultRequest;
  pendingFaultRequest = FAULT_REQUEST_NONE;

  // Diagnose aus -> Anfrage aus dem Web ablehnen
  if (diagDisabled) {
    faultMemoryValid = false;
    faultMemoryError = true;
    faultStatusText = "Diagnose aus (am Gerät 5 s drücken)";
    return;
  }

  faultRequestRunning = true;
  faultMemoryError = false;
  faultMemoryValid = false;
  


  bool result = false;
  kwpLinkError = false;

  // connectMSG() gibt sofort true zurück, wenn bereits verbunden
  if (connectMSG(startupFaultCheck ? 1 : MAX_CONNECT_ATTEMPTS)) {
    result = (request == FAULT_REQUEST_READ)
               ? readFaultMemory()
               : clearFaultMemory();
  }

  // Nur bei echtem Leitungsfehler trennen
  if (kwpConnected && kwpLinkError) {
    stopKLine(false);
    kwpConnected = false;
    lastConnectAttempt = millis();
  }

  if (result) {
    faultMemoryValid = true;

    if (faultCount == 0) {
      faultStatusText = (request == FAULT_REQUEST_CLEAR)
                          ? "Fehlerspeicher gelöscht"
                          : "Kein Fehler erkannt";
    } else {
      if (request == FAULT_REQUEST_CLEAR) {
        faultStatusText = "Gelöscht, aber Fehler weiterhin vorhanden";
      } else {
        faultStatusText = String(faultCount) + " Fehler gelesen";
      }
    }
  } else {
    faultMemoryError = true;
    faultStatusText = "Vorgang fehlgeschlagen";
  }

  faultRequestRunning = false;
  lastMeasurementTime = millis();

  // Nur beim Startcheck: gefundene FSP 10 s lang anzeigen
  if (startupFaultCheck && result && faultCount > 0) {
    fspNoticeActive = true;
    fspNoticeStart = millis();
  }

  startupFaultCheck = false;

  // Spannungsanzeige sofort neu zeichnen (mit/ohne "!")
  lastVoltageDisplay = 0;
  updateVoltageDisplay();
}




// =====================================================
// WEB-HANDLER
// =====================================================

void handleRoot() {
  lastWebRequest = millis();
  server.send(200, "text/html; charset=utf-8", INDEX_HTML);
}

// Gemeinsames Stylesheet aller Seiten
void handleAppCss() {
  server.sendHeader("Cache-Control", "max-age=86400");
  server.send(200, "text/css", APP_CSS);
}

// Codeblock aus der WebApp umschalten (?to=2 oder 3)
void handleApiCodeblock() {
  lastWebRequest = millis();

  const char *JSON_TYPE = "application/json; charset=utf-8";
  int to = server.arg("to").toInt();

  if (to != 2 && to != 3) {
    server.send(400, JSON_TYPE, "{\"ok\":false,\"msg\":\"Ungültiger Codeblock\"}");
    return;
  }
  if (diagDisabled) {
    server.send(409, JSON_TYPE, "{\"ok\":false,\"msg\":\"Diagnose ist aus\"}");
    return;
  }
  if (pendingCodeblockTarget != 0 || pendingFaultRequest != FAULT_REQUEST_NONE) {
    server.send(409, JSON_TYPE, "{\"ok\":false,\"msg\":\"Gerät ist beschäftigt\"}");
    return;
  }

  codeblockError = "";
  codeblockCyclePending = false;
  pendingCodeblockTarget = to;

  server.send(202, JSON_TYPE, "{\"ok\":true}");
}

// Meldung "Zündungswechsel" wurde bestätigt
void handleApiCodeblockAck() {
  lastWebRequest = millis();
  codeblockCyclePending = false;
  server.send(200, "application/json", "{\"ok\":true}");
}

// App-Icon (Browser-Tab und Startbildschirm)
void handleAppIcon() {
  server.sendHeader("Cache-Control", "max-age=86400");
  server.send_P(200, "image/png", (PGM_P)APP_ICON_PNG, APP_ICON_PNG_LEN);
}

void handleManifest() {
  server.sendHeader("Cache-Control", "max-age=86400");
  server.send(200, "application/manifest+json", APP_MANIFEST);
}

// Livewerte aller Bildschirme aus der OLED-Liste
//   k = 1 -> Wert kommt vom MSG (ohne Verbindung "-")
void handleApiLive() {
  lastWebRequest = millis();

  static const char *BASE_NAMES[6] = {
    "Spannung", "Drehzahl", "Ladedruck",
    "Verbrauch", "Durchschnitt", "Einspritzmenge"
  };

  String json = "{";
  json += "\"connected\":";
  json += kwpConnected ? "true" : "false";
  json += ",\"diag\":";
  json += diagDisabled ? "false" : "true";
  json += ",\"cb\":";
  json += displayMode == MODE_CODEBLOCK ? "true" : "false";
  json += ",\"cur\":";
  json += String(currentScreenId);
  json += ",\"coding\":";
  json += String(Coding);
  json += ",\"cbCycle\":";
  json += codeblockCyclePending ? "true" : "false";
  json += ",\"cbErr\":\"";
  json += jsonEscape(codeblockError);
  json += "\"";
  json += ",\"items\":[";

  for (uint8_t i = 0; i < screenCount; i++) {
    uint8_t id = screenList[i];
    String name, unit, value;
    bool fromMsg = true;

    if (id >= SCR_CUSTOM1 && id < SCR_CUSTOM1 + MAX_CUSTOM) {
      uint8_t slot = id - SCR_CUSTOM1;
      CustomScreen &c = customScreens[slot];

      name = strlen(c.title) > 0
               ? String(c.title)
               : "MWB " + String(c.group) + " Feld " + String(c.field);
      unit = strlen(c.unit) > 0 ? String(c.unit) : customLiveUnit[slot];
      value = customLive[slot].length() > 0 ? customLive[slot] : "-";
    } else if (id <= SCR_INJECTION) {
      name = BASE_NAMES[id];
      unit = baseUnits[id];

      switch (id) {
        case SCR_VOLTAGE:
          value = String(measuredVoltage, 1);
          fromMsg = false;
          break;
        case SCR_BOOST:       value = String(lastBoostMbar);              break;
        case SCR_CONSUMPTION: value = String(fuelConsumption, 1);         break;
        case SCR_AVERAGE:
          value = String(averageFuelConsumption, 1);
          fromMsg = false;   // bleibt nach Verbindungsabbruch gültig
          break;
        case SCR_RPM:         value = String(lastRpm);                    break;
        default:              value = String(injectionActual, 1);         break;
      }
    } else {
      continue;
    }

    if (i > 0) json += ",";
    json += "{\"id\":";
    json += String(id);
    json += ",\"n\":\"";
    json += jsonEscape(name);
    json += "\",\"u\":\"";
    json += jsonEscape(unit);
    json += "\",\"v\":\"";
    json += jsonEscape(value);
    json += "\",\"k\":";
    json += fromMsg ? "1" : "0";
    json += "}";
  }
  json += "]}";

  server.sendHeader("Cache-Control", "no-store");
  server.send(200, "application/json; charset=utf-8", json);
}

// =====================================================
// EINSTELLUNGEN (Flash, Namespace "cfg")
// =====================================================

// Gültigkeit prüfen, bei Fehler Meldung für die WebApp
String checkSettings(uint32_t lp, uint32_t dp, float vo) {
  if (lp < 1000 || lp > 10000) {
    return "Langer Druck: 1,0 bis 10,0 s";
  }
  if (dp < 2000 || dp > 20000) {
    return "Diagnose-Druck: 2,0 bis 20,0 s";
  }
  if (dp < lp + 1000) {
    return "Diagnose-Druck muss mind. 1 s länger sein als der lange Druck";
  }
  if (isnan(vo) || vo < -3.0f || vo > 3.0f) {
    return "Spannungskorrektur: -3,00 bis +3,00 V";
  }
  return "";
}

void loadSettings() {
  prefs.begin("cfg", true);
  uint32_t lp = prefs.getUInt("lp", DEFAULT_LONG_PRESS_MS);
  uint32_t dp = prefs.getUInt("dp", DEFAULT_DIAG_PRESS_MS);
  float vo = prefs.getFloat("vo", DEFAULT_VOLTAGE_OFFSET);
  prefs.end();

  // Kaputte Werte im Flash -> Standard verwenden
  if (checkSettings(lp, dp, vo).length() > 0) {
    lp = DEFAULT_LONG_PRESS_MS;
    dp = DEFAULT_DIAG_PRESS_MS;
    vo = DEFAULT_VOLTAGE_OFFSET;
  }

  buttonLongPressMs = lp;
  buttonDiagPressMs = dp;
  voltageOffset = vo;

  Serial.print("Einstellungen: lang ");
  Serial.print(lp);
  Serial.print(" ms, Diagnose ");
  Serial.print(dp);
  Serial.print(" ms, Offset ");
  Serial.print(vo, 2);
  Serial.println(" V");
}

void handleSettingsPage() {
  lastWebRequest = millis();
  server.send(200, "text/html; charset=utf-8", SETTINGS_HTML);
}

void handleApiSettings() {
  lastWebRequest = millis();

  String json = "{\"lp\":";
  json += String(buttonLongPressMs);
  json += ",\"dp\":";
  json += String(buttonDiagPressMs);
  json += ",\"vo\":";
  json += String(voltageOffset, 2);
  json += ",\"volt\":";
  json += String(measuredVoltage, 2);
  json += ",\"def\":{\"lp\":";
  json += String(DEFAULT_LONG_PRESS_MS);
  json += ",\"dp\":";
  json += String(DEFAULT_DIAG_PRESS_MS);
  json += ",\"vo\":";
  json += String(DEFAULT_VOLTAGE_OFFSET, 2);
  json += "}}";

  server.sendHeader("Cache-Control", "no-store");
  server.send(200, "application/json; charset=utf-8", json);
}

void handleApiSettingsSave() {
  lastWebRequest = millis();

  uint32_t lp = (uint32_t)server.arg("lp").toInt();
  uint32_t dp = (uint32_t)server.arg("dp").toInt();
  float vo = server.arg("vo").toFloat();

  String err = checkSettings(lp, dp, vo);
  if (err.length() > 0) {
    server.send(400, "application/json; charset=utf-8",
                "{\"ok\":false,\"msg\":\"" + jsonEscape(err) + "\"}");
    return;
  }

  buttonLongPressMs = lp;
  buttonDiagPressMs = dp;
  voltageOffset = vo;

  prefs.begin("cfg", false);
  prefs.putUInt("lp", lp);
  prefs.putUInt("dp", dp);
  prefs.putFloat("vo", vo);
  prefs.end();

  // Spannung sofort mit neuem Offset messen und anzeigen
  measureVoltage();
  lastVoltageDisplay = 0;

  Serial.println("Einstellungen gespeichert.");
  server.send(200, "application/json", "{\"ok\":true}");
}



void handleMwbPage() {
  lastWebRequest = millis();
  server.send(200, "text/html; charset=utf-8", MWB_HTML);
}

void handleApiMwb() {
  lastWebRequest = millis();
  lastMwbRequest = millis();

  if (server.hasArg("group")) {
    int g = server.arg("group").toInt();
    if (g >= 1 && g <= 255 && g != webMwbGroup) {
      webMwbGroup = (uint8_t)g;
      mwbCount = 0;
      mwbDataGroup = 0;
      mwbError = false;
    }
  }

  int idx = findMwbIndex(webMwbGroup);

  String json = "{\"connected\":";
  json += kwpConnected ? "true" : "false";
  json += ",\"group\":";
  json += String(webMwbGroup);
  json += ",\"dataGroup\":";
  json += String(mwbDataGroup);
  json += ",\"error\":";
  json += mwbError ? "true" : "false";
  json += ",\"title\":\"";
  json += idx >= 0 ? jsonEscape(String(MWB_TABLE[idx].title)) : String("");
  json += "\",\"cond\":\"";
  json += idx >= 0 ? jsonEscape(String(MWB_TABLE[idx].cond)) : String("");
  json += "\",\"fields\":[";

  for (uint8_t i = 0; i < mwbCount; i++) {
    if (i > 0) json += ",";

    String val = mwbData[i].isText
                   ? mwbData[i].text
                   : String(mwbData[i].value, 2);

    String name = "";
    String unit = mwbData[i].unit;

    if (idx >= 0 && i < 4) {
      name = MWB_TABLE[idx].f[i].name;

      // Einheit aus der Tabelle, falls die Formel keine liefert
      if (unit == "" || unit == "?") {
        unit = MWB_TABLE[idx].f[i].unit;
        if (unit == "-") unit = "";
      }
    }

    json += "{\"k\":";  json += String(mwbData[i].formula);
    json += ",\"a\":";  json += String(mwbData[i].a);
    json += ",\"b\":";  json += String(mwbData[i].b);
    json += ",\"v\":\""; json += jsonEscape(val);
    json += "\",\"u\":\""; json += jsonEscape(unit);
    json += "\",\"n\":\""; json += jsonEscape(name);
    json += "\"}";
  }

  json += "]}";

  server.sendHeader("Cache-Control", "no-store");
  server.send(200, "application/json; charset=utf-8", json);
}



// =====================================================
// FEHLERSPEICHER-HANDLER
// =====================================================

uint32_t lastFaultPageRequest = 0;

bool faultPageActive() {
  return lastFaultPageRequest != 0 &&
         (millis() - lastFaultPageRequest) < 3000;
}

void handleFaultPage() {
  lastWebRequest = millis();
  lastFaultPageRequest = millis();
  server.send(200, "text/html; charset=utf-8", FAULT_HTML);
}

void handleApiFaultRead() {
  lastWebRequest = millis();
  lastFaultPageRequest = millis();

  if (faultRequestRunning || pendingFaultRequest != FAULT_REQUEST_NONE) {
    server.send(409, "application/json", "{\"accepted\":false}");
    return;
  }

  pendingFaultRequest = FAULT_REQUEST_READ;
  faultStatusText = "Fehlerspeicher wird gelesen...";
  server.send(202, "application/json", "{\"accepted\":true}");
}

void handleApiFaultClear() {
  lastWebRequest = millis();
  lastFaultPageRequest = millis();

  if (faultRequestRunning || pendingFaultRequest != FAULT_REQUEST_NONE) {
    server.send(409, "application/json", "{\"accepted\":false}");
    return;
  }

  pendingFaultRequest = FAULT_REQUEST_CLEAR;
  faultStatusText = "Fehlerspeicher wird gelöscht...";
  server.send(202, "application/json", "{\"accepted\":true}");
}

void handleApiFaults() {
  lastWebRequest = millis();
  lastFaultPageRequest = millis();

  bool busy = faultRequestRunning ||
              pendingFaultRequest != FAULT_REQUEST_NONE;

  String json = "{\"running\":";
  json += busy ? "true" : "false";
  json += ",\"valid\":";
  json += faultMemoryValid ? "true" : "false";
  json += ",\"error\":";
  json += faultMemoryError ? "true" : "false";
  json += ",\"status\":\"";
  json += jsonEscape(faultStatusText);
  json += "\",\"faults\":[";

  for (uint8_t i = 0; i < faultCount; i++) {
    if (i > 0) json += ",";

    char hexCode[5];
    char hexType[3];
    sprintf(hexCode, "%04X", faultData[i].code);
    sprintf(hexType, "%02X", faultData[i].type);

    json += "{\"code\":\"";
    json += faultCodeText(faultData[i].code);
    json += "\",\"hex\":\"";
    json += hexCode;
    json += "\",\"typeHex\":\"";
    json += hexType;
    json += "\",\"sporadic\":";
    json += faultData[i].sporadic ? "true" : "false";
    json += ",\"text\":\"";
    json += jsonEscape(faultTypeText(faultData[i].type));
    json += "\"";

    int fi = findFaultIndex(faultData[i].code);

    json += ",\"known\":";
    json += (fi >= 0) ? "true" : "false";

    if (fi >= 0) {
      json += ",\"obd\":\"";    json += jsonEscape(String(FAULT_TABLE[fi].obd));
      json += "\",\"title\":\""; json += jsonEscape(String(FAULT_TABLE[fi].text));
      json += "\",\"cause\":\""; json += jsonEscape(String(FAULT_TABLE[fi].cause));
      json += "\",\"effect\":\""; json += jsonEscape(String(FAULT_TABLE[fi].effect));
      json += "\"";
    }

    json += "}";
  }

  json += "]}";

  server.sendHeader("Cache-Control", "no-store");
  server.send(200, "application/json; charset=utf-8", json);
}



// Nur druckbare ASCII-Zeichen, max. 9
void sanitizeLabel(String n, char *out) {
  n.trim();
  uint8_t k = 0;

  for (size_t i = 0; i < n.length() && k < 9; i++) {
    char ch = n[i];
    if (ch >= 0x20 && ch <= 0x7E) out[k++] = ch;
  }

  out[k] = 0;
}

void handleOledPage() {
  lastWebRequest = millis();
  server.send(200, "text/html; charset=utf-8", OLED_HTML);
}

void handleApiOled() {
  lastWebRequest = millis();

  String json = "{\"list\":[";
  for (uint8_t i = 0; i < screenCount; i++) {
    if (i > 0) json += ",";
    json += String(screenList[i]);
  }

	json += "],\"custom\":[";
	for (uint8_t i = 0; i < MAX_CUSTOM; i++) {
	  if (i > 0) json += ",";

	  json += "{\"g\":";
	  json += String(customScreens[i].group);

	  json += ",\"f\":";
	  json += String(customScreens[i].field);

	  json += ",\"title\":\"";
	  json += jsonEscape(String(customScreens[i].title));

	  json += "\",\"unit\":\"";
	  json += jsonEscape(String(customScreens[i].unit));

	  json += "\"}";
	}

  json += "],\"units\":[";
  for (uint8_t i = 0; i < 6; i++) {
    if (i > 0) json += ",";
    json += "\"";
    json += jsonEscape(String(baseUnits[i]));
    json += "\"";
  }
  json += "]}";

  server.sendHeader("Cache-Control", "no-store");
  server.send(200, "application/json; charset=utf-8", json);
}

void handleApiOledSave() {
  lastWebRequest = millis();

  String s = server.arg("list");
  uint8_t tmp[MAX_SCREENS];
  uint8_t n = 0;
  int start = 0;

  while (start < (int)s.length() && n < MAX_SCREENS) {
    int comma = s.indexOf(',', start);
    if (comma < 0) comma = s.length();

    int id = s.substring(start, comma).toInt();

    if (screenValid(id)) {
      bool dup = false;
      for (uint8_t i = 0; i < n; i++) {
        if (tmp[i] == id) dup = true;
      }
      if (!dup) tmp[n++] = (uint8_t)id;
    }

    start = comma + 1;
  }

  if (n == 0) {
    server.send(400, "application/json", "{\"ok\":false}");
    return;
  }

  memcpy(screenList, tmp, n);
  screenCount = n;

  saveOledConfig();
  syncScreenIndex();

  server.send(200, "application/json", "{\"ok\":true}");
}

// Text kürzen, ohne ein UTF-8-Zeichen zu zerschneiden
void copyUtf8Safe(const String &src, char *dst, size_t dstSize) {
  size_t len = src.length();
  if (len > dstSize - 1) {
    len = dstSize - 1;
    // Folgebytes (10xxxxxx) nicht am Ende stehen lassen
    while (len > 0 && ((uint8_t)src[len] & 0xC0) == 0x80) len--;
  }
  memcpy(dst, src.c_str(), len);
  dst[len] = 0;
}

// Eigenen Messwert anlegen (Klick auf MWB-Karte)
void handleApiOledCustom() {
  lastWebRequest = millis();

  int g = server.arg("g").toInt();
  int f = server.arg("f").toInt();

  if (g < 1 || g > 255 || f < 1 || f > 4) {
    server.send(400, "application/json; charset=utf-8",
      "{\"ok\":false,\"msg\":\"Ungültige Angabe\"}");
    return;
  }

  // Gleicher Block/Feld schon vorhanden -> aktualisieren
  int slot = -1;
  for (uint8_t i = 0; i < MAX_CUSTOM; i++) {
    if (customScreens[i].group == g && customScreens[i].field == f) slot = i;
  }

  // Sonst ersten freien Platz nehmen
  if (slot < 0) {
    for (uint8_t i = 0; i < MAX_CUSTOM; i++) {
      if (customScreens[i].group == 0) { slot = i; break; }
    }
  }

  if (slot < 0) {
    server.send(409, "application/json; charset=utf-8",
      "{\"ok\":false,\"msg\":\"Alle 8 Plätze belegt. Bitte unter OLED-Anzeige einen löschen.\"}");
    return;
  }

	String titleText = server.arg("title");
	titleText.trim();

	if (titleText.length() == 0) {
	  titleText =
		"MWB " + String(g) +
		" Feld " + String(f);
	}

	String unitText = server.arg("unit");

	char unit[10];
	sanitizeLabel(unitText, unit);

	customScreens[slot].group = (uint8_t)g;
	customScreens[slot].field = (uint8_t)f;

	memset(
	  customScreens[slot].title,
	  0,
	  sizeof(customScreens[slot].title)
	);

	copyUtf8Safe(
	  titleText,
	  customScreens[slot].title,
	  sizeof(customScreens[slot].title)
	);


	memset(
	  customScreens[slot].unit,
	  0,
	  sizeof(customScreens[slot].unit)
	);

	memcpy(
	  customScreens[slot].unit,
	  unit,
	  sizeof(customScreens[slot].unit)
	);

  // In die Liste aufnehmen, falls noch nicht drin
  uint8_t id = SCR_CUSTOM1 + slot;
  bool inList = false;
  for (uint8_t i = 0; i < screenCount; i++) {
    if (screenList[i] == id) { inList = true; screenIndex = i; }
  }
  if (!inList && screenCount < MAX_SCREENS) {
    screenList[screenCount] = id;
    screenIndex = screenCount;
    screenCount++;
  }

  saveOledConfig();

  // Sofort auf dem OLED anzeigen
  applyScreen(id);

  server.send(200, "application/json", "{\"ok\":true}");
}

// Eigenen Messwert löschen
void handleApiOledDelete() {
  lastWebRequest = millis();

  int slot = server.arg("slot").toInt();
  if (slot < 0 || slot >= MAX_CUSTOM) {
    server.send(400, "application/json", "{\"ok\":false}");
    return;
  }

  memset(&customScreens[slot], 0, sizeof(CustomScreen));

  // Aus der Reihenfolge entfernen
  uint8_t id = SCR_CUSTOM1 + slot;
  uint8_t w = 0;
  for (uint8_t i = 0; i < screenCount; i++) {
    if (screenList[i] != id) screenList[w++] = screenList[i];
  }
  screenCount = w;

  if (screenCount == 0) {
    screenList[0] = SCR_VOLTAGE;
    screenCount = 1;
  }

  saveOledConfig();

  // Wird der gelöschte Wert gerade angezeigt -> ersten Bildschirm zeigen
  syncScreenIndex();

  server.send(200, "application/json", "{\"ok\":true}");
}

// Einheit / Bezeichnung ändern
void handleApiOledUnit() {
  lastWebRequest = millis();

  int id = server.arg("id").toInt();

  char label[10];
  sanitizeLabel(server.arg("n"), label);

  if (id >= SCR_VOLTAGE && id <= SCR_INJECTION && screenValid(id)) {

    // Leer -> Standard wiederherstellen
    if (label[0] == 0) {
      strcpy(label, DEFAULT_UNITS[id]);
    }
    memcpy(baseUnits[id], label, sizeof(label));

  } else if (id >= SCR_CUSTOM1 &&
             id < SCR_CUSTOM1 + MAX_CUSTOM &&
             customScreens[id - SCR_CUSTOM1].group != 0) {

    // Leer -> Einheit aus der Kennzahl wird angezeigt
	memcpy(
	  customScreens[id - SCR_CUSTOM1].unit,
	  label,
	  sizeof(label)
	);

  } else {
    server.send(400, "application/json", "{\"ok\":false}");
    return;
  }

  saveOledConfig();

  // Läuft der Bildschirm gerade, sofort neu zeichnen
  if (displayMode != MODE_CODEBLOCK && currentScreenId == id) {
    if (displayMode == MODE_VOLTAGE) {
      lastVoltageDisplay = 0;
      updateVoltageDisplay();
    } else {
      oledShowNormal();
    }
  }

  String json = "{\"ok\":true,\"n\":\"";
  json += jsonEscape(String(label));
  json += "\"}";

  server.send(200, "application/json; charset=utf-8", json);
}

// =====================================================
// SETUP
// =====================================================

void setup() {
    // Serieller Monitor für Debug-Ausgaben
  Serial.begin(115200);

#if ARDUINO_USB_CDC_ON_BOOT
  // Ohne angeschlossenen PC darf Serial die K-Line-Zeiten nicht blockieren
  Serial.setTxTimeoutMs(0);
#endif

  // Gespeicherte OLED-Konfiguration und Einstellungen laden
  // (vor dem Taster-Task, der die Tastendauer nutzt)
  loadOledConfig();
  loadSettings();

  // ------------------------------------------
  // K-LINE
  // ------------------------------------------

  pinMode(KLINE_TX, OUTPUT);
  digitalWrite(KLINE_TX, HIGH);

  pinMode(KLINE_RX, INPUT);


  // ------------------------------------------
  // TASTER
  // ------------------------------------------

  pinMode(BUTTON_OUTPUT, OUTPUT);
  digitalWrite(BUTTON_OUTPUT, LOW);

  pinMode(BUTTON_INPUT, INPUT_PULLUP);

  buttonQueue = xQueueCreate(BUTTON_QUEUE_LEN, sizeof(ButtonEvent));

  // Priorität 2 > loop() (1): Taster wird auch während
  // KWP-Kommunikation und delay() zuverlässig abgefragt
  xTaskCreate(buttonTask, "button", 2048, nullptr, 2, nullptr);


  // ------------------------------------------
  // LED TEST
  // ------------------------------------------

  pinMode(LED_PIN, OUTPUT);
  digitalWrite(LED_PIN, LOW);
  
  
    // ------------------------------------------
  // WLAN-HOTSPOT + WEBSERVER
  // ------------------------------------------

  WiFi.mode(WIFI_AP);
  WiFi.softAP(AP_SSID, AP_PASS);

  // Beim ESP32-C3 SuperMini ist WLAN bei voller
  // Sendeleistung oft instabil -> reduzieren
  WiFi.setTxPower(WIFI_POWER_8_5dBm);

  server.on("/", handleRoot);
  server.on("/app.css", HTTP_GET, handleAppCss);
  server.on("/icon.png", HTTP_GET, handleAppIcon);
  server.on("/manifest.json", HTTP_GET, handleManifest);
  server.on("/api/codeblock", HTTP_POST, handleApiCodeblock);
  server.on("/api/codeblock/ack", HTTP_POST, handleApiCodeblockAck);
  server.on("/api/live", handleApiLive);
  server.on("/mwb", handleMwbPage);
  server.on("/api/mwb", handleApiMwb);

  server.on("/faults", HTTP_GET, handleFaultPage);
  server.on("/api/faults", HTTP_GET, handleApiFaults);
  server.on("/api/faults/read", HTTP_POST, handleApiFaultRead);
  server.on("/api/faults/clear", HTTP_POST, handleApiFaultClear);

  server.on("/oled", HTTP_GET, handleOledPage);
  server.on("/api/oled", HTTP_GET, handleApiOled);
  server.on("/api/oled/save", HTTP_POST, handleApiOledSave);
  server.on("/api/oled/custom", HTTP_POST, handleApiOledCustom);
  server.on("/api/oled/delete", HTTP_POST, handleApiOledDelete);
  server.on("/api/oled/unit", HTTP_POST, handleApiOledUnit);

  server.on("/settings", HTTP_GET, handleSettingsPage);
  server.on("/api/settings", HTTP_GET, handleApiSettings);
  server.on("/api/settings/save", HTTP_POST, handleApiSettingsSave);

  server.begin();

  Serial.print("Hotspot gestartet, IP: ");
  Serial.println(WiFi.softAPIP());

  // Diagnose-Schalter aus dem Flash
  prefs.begin("diag", true);
  diagDisabled = prefs.getBool("off", false);
  prefs.end();

  // Beim Start einmal den Fehlerspeicher lesen (nur bei Diagnose an).
  // Ausgeführt wird das im ersten loop()-Durchlauf.
  if (diagDisabled) {
    Serial.println("DIAGNOSE AUS (gespeichert) - kein Startcheck");
    faultStatusText = "Diagnose aus";
  } else {
    startupFaultCheck = true;
    pendingFaultRequest = FAULT_REQUEST_READ;
    faultStatusText = "Startcheck: Fehlerspeicher wird gelesen...";
  }
  // ------------------------------------------
  // OLED
  // ------------------------------------------

  Wire.begin(
    OLED_SDA,
    OLED_SCL);

  if (!display.begin(
        SSD1306_SWITCHCAPVCC,
        OLED_ADDRESS)) {

    // Keine Serial-Ausgabe mehr.
    // Falls OLED nicht funktioniert,
    // läuft die K-Line trotzdem weiter.

    return;
  }

  // ------------------------------------------
  // VW STARTLOGO
  // ------------------------------------------

  display.clearDisplay();

  display.drawBitmap(
    0,
    15,
    vwLogo,
    64,
    40,
    SSD1306_WHITE);

  display.display();

  delay(1500);

  // Erster Bildschirm aus der gespeicherten Liste
  screenIndex = 0;
  applyScreen(screenList[0]);
}

// =====================================================
// LOOP
// =====================================================

void loop() {
  server.handleClient();

  handleButton();

  // Fehlerspeicher und Codeblock-Wechsel haben Vorrang
  processFaultRequest();
  processCodeblockRequest();
  kwpKeepAlive();

  if (!faultRequestRunning &&
      pendingFaultRequest == FAULT_REQUEST_NONE) {
    updateMeasurements();
  }

  delay(5);
}
