HLukas1/CodeBlockSwitchT4/AppIcon.h

#pragma once
#include <Arduino.h>

// WebApp-Icon: PNG, 192x192 px (Quelle: images/app_icon.png)
const uint8_t APP_ICON_PNG[] PROGMEM = {
  0x89, 0x50, 0x4e, 0x47, 0x0d, 0x0a, 0x1a, 0x0a, 0x00, 0x00, 0x00, 0x0d, 0x49, 0x48, 0x44, 0x52,
  0x00, 0x00, 0x00, 0xc0, 0x00, 0x00, 0x00, 0xc0, 0x08, 0x02, 0x00, 0x00, 0x00, 0xdd, 0xbe, 0xfb,
  0x50, 0x00, 0x00, 0x0a, 0xb5, 0x49, 0x44, 0x41, 0x54, 0x78, 0xda, 0xed, 0x9d, 0x2f, 0x5c, 0xdb,
  0x5a, 0x14, 0xc7, 0x23, 0x9f, 0x78, 0x02, 0x51, 0x51, 0x11, 0x11, 0x11, 0x11, 0x11, 0x11, 0x11,
  0x11, 0x11, 0x51, 0x11, 0x51, 0x51, 0x51, 0x51, 0x81, 0xa8, 0xa8, 0x40, 0x20, 0x10, 0x08, 0x04,
  0xa2, 0x02, 0x81, 0x40, 0x4c, 0x20, 0x26, 0x10, 0x08, 0xc4, 0x04, 0x02, 0x81, 0x78, 0x02, 0x81,
  0x98, 0x98, 0x40, 0x4c, 0x20, 0x10, 0x13, 0x4f, 0x4c, 0x4c, 0x3c, 0x31, 0x31, 0x31, 0xf1, 0xdc,
  0x7b, 0x27, 0x6d, 0x57, 0xba, 0x92, 0x26, 0xe7, 0xa6, 0x69, 0xee, 0xbf, 0xdf, 0xe7, 0xf3, 0x13,
  0x0c, 0xd6, 0xe4, 0x26, 0xfd, 0xe6, 0x9c, 0xdf, 0x39, 0xf7, 0x26, 0x71, 0x3a, 0x5e, 0x04, 0x41,
  0xb5, 0xe5, 0xe0, 0x14, 0x40, 0x00, 0x08, 0x02, 0x40, 0x10, 0x00, 0x82, 0x00, 0x10, 0x04, 0x01,
  0x20, 0x08, 0x00, 0x41, 0x00, 0x08, 0x02, 0x40, 0x10, 0x04, 0x80, 0x20, 0x00, 0x04, 0x01, 0x20,
  0x08, 0x00, 0x41, 0x10, 0x00, 0x82, 0x00, 0x10, 0x04, 0x80, 0x20, 0x00, 0x04, 0x41, 0x00, 0x08,
  0x6a, 0x02, 0xa0, 0x10, 0x82, 0x6a, 0x0b, 0x00, 0x41, 0x00, 0x08, 0x02, 0x40, 0x10, 0x00, 0x82,
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
  0xa4, 0x56, 0xbb, 0xfb, 0x40, 0x27, 0x61, 0x56, 0x97, 0x01, 0x20, 0xc1, 0x33, 0x5e, 0xaf, 0x62,
  0xa7, 0xd3, 0xed, 0x0f, 0x8e, 0xd4, 0x3c, 0x28, 0x1a, 0x58, 0xbd, 0x4b, 0x82, 0x4e, 0x85, 0x52,
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
};

const size_t APP_ICON_PNG_LEN = sizeof(APP_ICON_PNG);
