HLukas1/CodeBlockSwitchT4/(commit log)

2026-10-02 Verbrauch unter 4km/h wird 0 l/100km
2026-10-07 V2
    OLED kann überWebApp bearbeitet Werden
    und FSP Können Gelesen werden
2026-10-12 Update CodeBlockSwitschT4_V2.ino
    Bugfix und Codeblock Wechsln verbessert
2026-10-15 Bugfix KeepAlive und Ladedruck
    Ladedruck jetzt Abzüglich atmospärdruck
    und Keepalive eingebaut
2026-10-28 Fahrt-Durchschnitt auch im Spannungsmodus berechnen
    Im Spannungsmodus wurde ohne offene Webseite nicht mit dem MSG
    kommuniziert, daher zaehlte der Durchschnitt erst nach dem ersten
    Bildschirmwechsel. Jetzt werden MWB 1 + 6 auch dort alle 2 s gelesen.
2026-11-06 WebApp überarbeitet, Einstellungen, Codeblock in der App, neues README
    - Projekt in den Hauptordner verschoben, Sketch heißt CodeBlockSwitchT4.ino
    - Diagnose aus/an per langem Tastendruck im Spannungsbildschirm (für VCDS)
    - WebApp neu gestaltet: Tab-Navigation, Live-Seite zeigt alle OLED-Werte
    - Einstellungen in der WebApp: Tastendauer, Diagnose-Dauer, Spannungskorrektur
    - Codeblock 102/138 PS auf der Live-Seite anzeigen und umschalten
    - App-Icon und Manifest für den Startbildschirm
    - Stromlaufplan, Screenshots, OLED-Grafik und README neu
    [T4 Codeblock Switcher.stl]
2026-11-06 README: Hinweis, dass die Leistungsänderung eine angepasste Motorsoftware braucht
2026-11-06 README: Foto vom eingebauten Gerät und Video (ohne Ton) ergänzt
